tw-xy/LintLizard/README.md

# LintLizard —— 履带扫地机器人 · 固件仓库



> **LintLizard** 是我给这台履带扫地机器人起的名字：**Lint**（毛絮、灰尘）+ **Lizard**（蜥蜴）——
> 一只贴着地面爬来爬去、专门吃掉毛絮的蜥蜴。
>
> 本仓库是它的**固件与文档**，会跟着功能一起长大。目前已经完成
> **遥控底盘、电调驱动、OLED 状态显示、扫地执行机构和激光雷达前向避障**；
> 后面继续加入自动回充、树莓派建图、编码器闭环等功能。

```
手机 Blinker 摇杆 → ESP8266-01S → CH32V307 → 标准差速转向 → 双有刷电调 → 履带底盘
```

板子：**CH32V307V-EVT**（丝印 `CH32F&V30xV-R1-1v1`，主控 CH32V307VCT6，板载 WCH-Link）

> 仓库名对应的是**整机**（LintLizard），不是当前阶段，所以以后加功能不用改名；
> 要区分版本时用 `LintLizard-v1` 这种形式。

## 当前进度

| 阶段 | 状态 |
|---|---|
| 一、娱乐与遥控（摇杆 → 串口协议 → 差速解算 → COM4 打印） | ✅ 已完成并实测 |
| 二、电调输出（TIM3 双路 50Hz / 1000–2000µs PWM） | ✅ 已实测；轮子转向已确认 |
| 三、OLED 状态显示（SSD1306 软 I2C） | ✅ 已烧录并跑通状态机；屏幕观感待确认 |
| 四、扫地执行机构（边刷 EN + 涡轮风机缓启动） | ✅ 已实测 |
| 五、激光雷达（YDLIDAR X2 兼容） | ✅ CH32 数据链路 + PC 端 EaiLidarTest 点云 + 前向避障均已验证 |
| 六、树莓派上位机（Web 控制台） | ✅ WiFi + SSH + 串口 + MJPEG + 网页摇杆 + **真实雷达点云**；新固件已烧录，约 409 点/秒，网页实测显示，双向串口验证通过 |
| 后续 | 落地跑直线/原地转 / 避障阈值精调 / 树莓派建图 / 编码器闭环（架构已预留接口） |

## Web 控制台实测

虚拟摇杆、W/A/S/D 键盘、CSI 摄像头 MJPEG 与实时雷达点云同屏显示。
W 前进、S 后退、A 左转、D 右转，支持组合键；松开、空格、Esc 或切走窗口停车。
键盘速度默认 50%，可调 20%～100%；网页指令使用纯手动模式，松手保持停止。

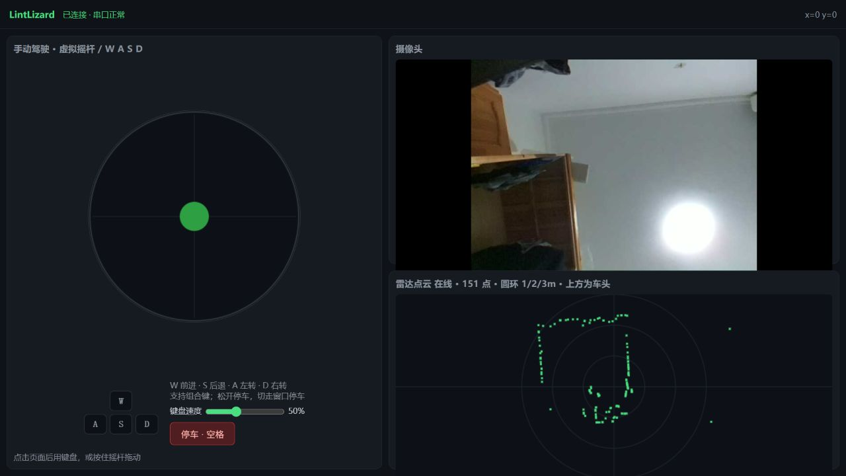
[picture p1: docs/images/20260922_05_web_wasd.png]
WASD 键盘控制界面


2026-09-22 用户提供的点云联调截图：

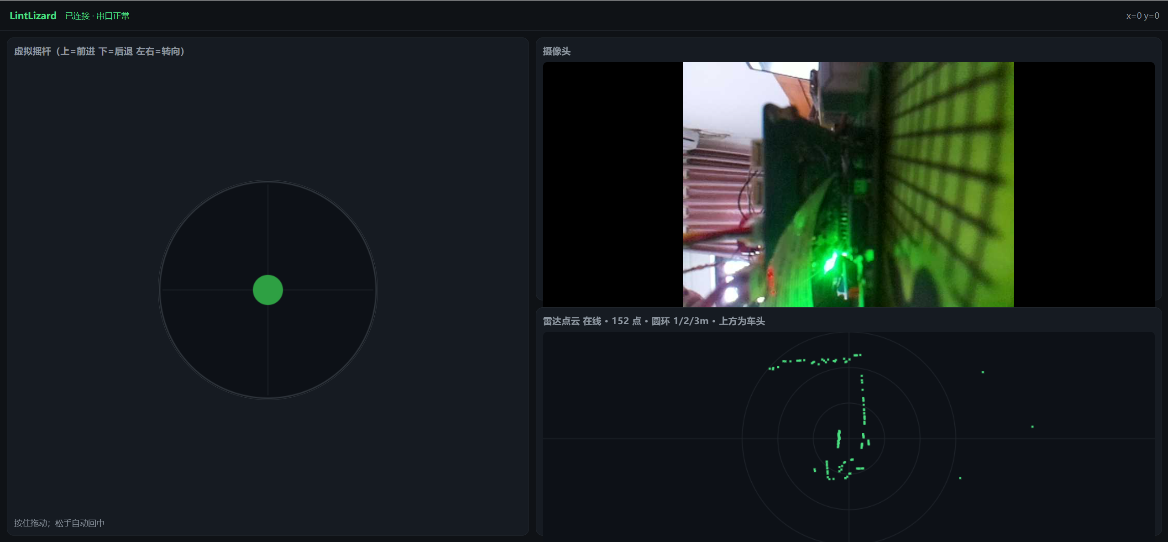
[picture p2: docs/images/20260922_04_web_console_user.png]
LintLizard Web 控制台：摇杆、摄像头与实时雷达点云


## 目录结构

```
User/  Bsp/  App/        CH32V307 固件源码
  User/main.c            主循环时间片调度
  Bsp/bsp_time.c         TIM2 1ms 时基 + 软定时器
  Bsp/bsp_uart.c         USART1 调试口 / USART3 遥控口（中断 + 环形缓冲）
  Bsp/bsp_motor.c        TIM3_CH1/CH2 → 两路电调 PWM
  App/app_remote.c       行协议解析 + 链路超时
  App/app_chassis.c      差速解算（换底盘只动这里）
  App/app_config.h       全部可调参数
sdk/                     随仓库自带的一份 WCH 官方库（Core/Peripheral/Ld/Startup）
esp8266/ESP8266_Blinker_Joy/   ESP8266 端 Arduino 工程
pi/                       树莓派上位机 Web 控制台（摇杆 + MJPEG 摄像头 + 点云）
  pi/server.py            纯标准库 HTTP 服务：/cmd → /dev/serial0、/video MJPEG
  pi/lintlizard-web.service  systemd 开机自启
  pi/README.md             部署与排查
backup/                       出厂固件备份（想恢复出厂时用，见 backup/README.md）
docs/                    接线表 / 避坑清单 / 编译环境 / 开发日志 / AI 提示词
build.ps1 flash.ps1 log.ps1    编译 / 烧录 / 串口记录
```

## 五分钟上手

```powershell
cd <本仓库目录>

# 1. 编译（输出 build\CAR_REMOTE.elf / .hex / .bin）
powershell -ExecutionPolicy Bypass -File .\build.ps1

# 2. 烧录（WCH-LinkE，会覆盖板子上现有程序）
powershell -ExecutionPolicy Bypass -File .\flash.ps1

# 3. 看板子在说什么（COM4 @115200，存到 logs\serial_*.log）
powershell -ExecutionPolicy Bypass -File .\log.ps1 -Seconds 60
```

正常应该看到：

```
[cmd ] x=  +0 y=  +0 | L=   +0 R=   +0 | 1500/1500 us | ok
[stat] LINK-OK  frames=2971 (48/s) err=0 rx=41594 rxovf=0 txdrop=0
```

ESP8266 端：用 Arduino IDE 打开 `esp8266/ESP8266_Blinker_Joy/`，
把 `secrets.h.example` 复制成 `secrets.h` 填上 WiFi / Blinker Secret Key（该文件已被 git 忽略），
开发板选 `Generic ESP8266 Module` / `1MB (FS:none OTA:~502KB)` / 26MHz / 80MHz。

## 硬件接线

见 [docs/接线表.md](docs/接线表.md)：板子 ↔ ESP8266、板子 ↔ 电调、板子 ↔ USB-TTL，
以及**板子上已经被占用的引脚清单**（接新东西前先看这张表）。

## 文档

| 文档 | 用途 |
|---|---|
| [docs/接线表.md](docs/接线表.md) | 全部接线 + 电源拓扑 + 已占用引脚 |
| [docs/避坑Checklist.md](docs/避坑Checklist.md) | 出问题先翻这个（串口乱码/连不上云/烧不进…） |
| [docs/编译环境.md](docs/编译环境.md) | 需要装什么、什么版本、怎么验证、怎么排错 |
| [docs/开发日志.md](docs/开发日志.md) | 完整开发记录：协议、算法、实测数据、踩坑过程 |
| [docs/下一步AI提示词.md](docs/下一步AI提示词.md) | 开新对话继续开发时，直接粘给 AI 的上下文 |

## 设计要点

* **非阻塞**：`BSP_Millis()` + `BSP_Every()` 时间片；串口收发全中断 + 环形缓冲；**没有任何 `Delay_Ms()` 死等**
* **三层失效保护**：ESP 端 1s 无摇杆数据回中 → 链路 300ms 无有效帧判离线 → 底盘 300ms 无新指令输出归零
* **协议可扩展**：`{"x":-100,"y":100}\n` 一行一帧，只认 `{` 开头的行，多余的键随便加
* **归一化差速**：`l=y+x, r=y-x` 后等比缩放，保证"斜着推"时转向比例不失真

## 后续扩展接口

| 功能 | 加在哪 | 接口 |
|---|---|---|
| 编码器测速 / PID | `Bsp/bsp_encoder.c` + `App/app_chassis.c` | 复用 `Chassis_Output_t` |
| 扫地（主扫/吸尘/边刷） | `App/app_cleaner.c` | 新增 PWM 通道 |
| 自动回充（红外 + 触点） | `App/app_charge.c` | 调 `Chassis_SetInput()` |
| ToF/超声波避障 | `App/app_avoid.c` | 在 `main.c` 里与遥控做仲裁 |
| OLED / WS2812 | `App/app_ui.c` | 只读状态，不阻塞 |

## 说明

* `sdk/` 为 WCH 官方 CH32V30x 外设库（随 EVT 包分发），版权归南京沁恒微电子所有，此处仅为便于编译而随仓库附带。
* 本仓库不包含任何 WiFi 密码或设备密钥。
