tw-xy/LintLizard/docs/任务交接摘要.md

# LintLizard 任务交接摘要

> 生成时间：2026-09-22
> 仓库：https://github.com/tw-xy/LintLizard （public，分支 `main`）
> 本地工程：`D:\WCH_CH32V307_EVT\projects\CAR_REMOTE`
> 用途：开新对话时把这份内容整段粘进去，即可无损接手。

---

## 1. 当前核心目标（一句话）

**把 LintLizard 履带扫地机器人的上位机从「ESP8266 + 点灯科技」迁到「树莓派 3B+ 网页控制」。**
网页的虚拟摇杆、摄像头 MJPEG 和**真实雷达点云均已打通**；2026-09-22 新固件已烧录并完成静态联调。

---

## 2. 环境（已装好，不要再问用户路径）

| 项 | 值 |
|---|---|
| 板子 | CH32V307V-EVT（丝印 `CH32F&V30xV-R1-1v1`，主控 CH32V307VCT6，板载 WCH-Link） |
| IDE | `D:\MounRiverStudio\MounRiver_Studio2` |
| 工具链 | `...\WCH\Toolchain\RISC-V Embedded GCC\bin` |
| 烧录 | `...\WCH\OpenOCD\OpenOCD\bin\openocd.exe` + 同目录 `wch-riscv.cfg`（WCH-LinkE，SDI 两线；脚本里路径**必须用正斜杠**） |
| 板子串口 | **COM4 @115200**（USART1 → 板载 WCH-Link 透传，可直接读写） |
| ESP 端 | Arduino IDE 2.3.10 + esp8266 3.1.2 + Blinker 库 |
| 代理 | Clash Verge Rev，**TUN 模式必须保持关闭**（开了会劫持局域网 IPv4，连不上树莓派） |

树莓派：Raspberry Pi 3B+，Raspberry Pi OS Lite 64-bit (Trixie)，hostname `lintlizard`，用户 `pi`

- SSH 公钥免密已配好：私钥 `C:\Users\hp\.ssh\lintlizard_ed25519`
- WiFi `miaomiaomao2.4G` → `192.168.1.5`（autoconnect，**WiFi 省电已关闭**）
- 历史备用地址：Ethernet `192.168.1.213`
- 最近实测 Web 服务、键盘界面、雷达均正常；用户随后已给小车断电，计划晚上继续。
  WASD 网页和配套固件已在断电前部署/烧录校验成功；晚上上电后刷新页面，先验证实际按键行驶，通常无需重复烧录。

---

## 3. 已完成进度

| 阶段 | 状态 |
|---|---|
| 一、遥控（摇杆 → ESP8266 → USART3 → 差速解算 → COM4） | ✅ 实测通过 |
| 二、电调驱动（TIM3_CH1/CH2，50Hz / 1000–2000µs） | ✅ 实测，轮子转向已确认 |
| 三、OLED（SSD1306 软 I2C，三态界面 + 方向箭头） | ✅ 已跑通（`oled=1`） |
| 四、扫地执行机构（边刷 EN + 涡轮风机 18kHz 缓启动） | ✅ 实测通过 |
| 五、激光雷达（YDLIDAR X2 兼容） | ✅ CH32 侧 9400 B/s；PC 端 EaiLidarTest 点云；前向避障四态全通过 |
| 特别版：自动巡航 `App/app_roam.c` | ✅ 已烧录；旧 ESP 指令推杆武装/下拉急停；网页 `manual=1` 纯手动，松手保持停止 |
| 六、树莓派上位机 | ✅ SSH / WiFi / 串口 / 摇杆 / 摄像头 / **真实网页点云**；固件已烧录，静态双向串口联调通过 |

Web 控制台现状：`http://192.168.1.5:8080/`

- 左边虚拟摇杆 → 实测通到 CH32（`LINK-OK`、约 8 帧/秒、解算正确）
- 已追加 WASD 键盘：W前进/S后退/A左转/D右转，组合键、速度20%～100%（默认50%），空格/Esc停车；失焦/隐藏/取消触控回中。网页现在统一纯手动，100ms持续发送；配套固件已烧录，静态10帧/秒、err=0、rxovf=0，非零方向仅隔离测试。
- 右上摄像头 MJPEG → OV5647 实测 6 秒 73 帧（约 12fps）
- 右下**真实雷达点云已显示**：约409点/秒，5.33s 测试期间保留140–177个新鲜点，Pi解析错误增量0。
- 新 Pi 接收服务已部署：`R,angle_cdeg,dist_mm`，每度最新点，0.5s 过期；状态可看 `/status.radar`。
- 固件编译、Pi 7 项测试与 C 解析器主机测试通过；OpenOCD 烧录 Verified OK。
- 双向串口实测50条回中指令，LINK-OK、err=0、rxovf=0，电调1500/1500µs；未测试非零摇杆/落地。
- 启动初期转发丢弃6点，之后累计不增；截图 `docs/images/20260922_03_web_radar_live.png`。

---

## 4. 当前引脚分配（实际接线）

| 功能 | 引脚 / 板子位置 |
|---|---|
| 左电调信号 | PA6 = J4-29（TIM3_CH1，50Hz，1500µs=停） |
| 右电调信号 | PA7 = J4-31（TIM3_CH2） |
| 吸尘电调 | PB0 = J4-17（TIM3_CH3） |
| 涡轮风机 PWM | PB8 = J4-25（TIM4_CH3，18kHz 占空比） |
| 边刷 1 / 2 EN | PE8 = J3-43 / PE10 = J3-45（高电平开） |
| OLED | SCL→PB6=J4-22、SDA→PB7=J4-20（I2C1，地址 0x3C） |
| 雷达 | Tx → PA3 = J3-34（USART2_RX，115200）；M_CTR 接 3.3V（**不是 RXD**） |
| 树莓派 AAT-1 | AAT-1 RX→J4-1(PB10/USART3_TX)、AAT-1 TX→J4-3(PB11/USART3_RX)、GND→J4-7、**5V 不接** |
| 调试串口 | PA9/PA10（USART1）→ 板载 WCH-Link → COM4 |
| 电调红线 | BEC 悬空包好，**绝不能接进板子** |

---

## 5. 树莓派侧已做的系统改动

- **UART**：`/boot/firmware/config.txt` 末尾（`[all]` 段）加 `enable_uart=1` + `dtoverlay=disable-bt`；
  `/boot/firmware/cmdline.txt` 去掉 `console=serial0,115200`；重启后 `/dev/serial0 -> ttyAMA0`（PL011，115200 8N1）
- **WiFi 省电**：`nmcli connection modify miaomiaomao2.4G wifi.powersave 2`
- **Web 服务**：`pi/server.py`（纯标准库，无 pip 依赖）+ `pi/lintlizard-web.service`（systemd 开机自启）
  - 部署：`scp pi/server.py pi@<IP>:/home/pi/lintlizard-server.py`
  - 排查：`systemctl status lintlizard-web` / `journalctl -u lintlizard-web -n 50` / `curl -s localhost:8080/status`
  - 接口：`/` 页面、`/cmd?x=&y=` 指令、`/video` MJPEG、`/scan` 点云、`/status` 状态

---

## 6. 已排除的错误方案 / 必须记住的坑

1. **ESP8266 的 EN 必须接 3.3V**，悬空不启动（蓝灯不亮）
2. **ESP 供电不能从 USB-TTL 或板子 3.3V 取**，要独立 3.3V（≥500mA）
3. **YDLIDAR X2 第 4 脚是 `M_CTR`（电机调速），不是卖家标的 `RXD`**
4. **Raspberry Pi Imager 2.0.11.1 会崩**（`libstdc++-6.dll`），用 **1.9.6**
5. **Clash TUN 会劫持局域网 IPv4**：症状是 IPv4 超时但 IPv6 通、ARP 通 → 关掉 TUN
6. **中文 SSID 在 Linux 控制台打不出来** → 改英文；路由器**实际 2.4G 名是 `miaomiaomao2.4G`**（是 `mao` 不是 `miao`），5G 才是 `miaomiaomiao5G`
7. **树莓派 UART 默认没开**（`/dev/ttyAMA0` 都不存在），按第 5 节那三步改
8. **WiFi 省电会导致树莓派随机掉线**，已关
9. `.ps1` 在 PowerShell 5.1 会中文乱码 → 脚本一律纯 ASCII
10. **Clash fake-IP 会让 `lintlizard.local` 解析到 `198.18.0.x`** → 直接用真实 IP
11. 树莓派**屏蔽 ICMP**，`ping` 不通不代表掉线，要用 SSH/端口判活
12. `git` 里已经把 `*.py/*.service/*.sh` 设为 LF（`.gitattributes`）

---

## 7. 尚未解决 / 当前阻塞点

1. **点云阻塞已解决**：TX→PA3/J3-34、GND→J4-7、VCC→独立5V、M_CTR→3.3V。
   `app_radar.c` 抽样转发、`ESP_TryWriteFrame` 整行入队，Pi `RadarBuffer` 接收并过期清理。
   当前是局部实时点云显示，尚未做建图或定位。
2. 网页**没有登录验证**（本地还行，暴露公网很危险）
3. **无法远程访问**（`192.168.1.5` 是局域网私有地址）。要远程建议装 **Tailscale**（免公网 IP、免端口映射、加密）
4. 落地跑**直线 / 原地转**还没做
5. **编码器 + IMU 暂缓采购**（用户已决定）

---

## 8. 下一步具体行动（接手后第一步）

1. 让用户给车上电，确认连通：
   `ssh -i C:\Users\hp\.ssh\lintlizard_ed25519 pi@192.168.1.5 "hostname; systemctl is-active lintlizard-web"`
2. 点云已完成，不要重复烧录。若检查状态，可核对 COM4 `[rad]` / `[scan] sent/drop`
   与 Pi `/scan`、`/status.radar`。静态检查保持摇杆回中；当前网页为纯手动，旧 ESP 指令仍可能武装巡航。
3. 下一任务按用户选择：网页登录验证 → Tailscale 远程 → 落地跑直线/原地转。

---

## 9. 协作约定（务必遵守）

- 分工：**用户负责下载/安装/物理接线/拍照；AI 负责写代码、编译、烧录、读串口、更新文档**
- **凡是会覆盖板子程序的（烧录），先说一声再动手**
- 涉及接线时，给「**板子端引脚 + 模块端引脚**」的接线表
- 每个里程碑：**提交 git + 更新文档**
- 用户**不熟悉命令行**：尽量少让他敲命令，命令给短、给明确
- 交流用中文，**先说结论**，再给依据
- 用户累了会暂停，不要催

---

## 10. 远期规划与架构要求

- 远期：扫地主刷/滚刷、自动回充（红外寻桩 + 触点）、ToF/超声波、GPS/罗盘、OLED 弹幕、WS2812、ESP32-CAM 图传
- 架构硬要求：**非阻塞**（时间片轮询），**严禁 `Delay_Ms()` 死等**；
  分层 `User/(主循环) Bsp/(时基/串口/电机/风机/OLED) App/(协议/差速/扫地/雷达/避障/巡航/UI)`，参数集中在 `App/app_config.h`
- 失效保护三层：ESP/Pi 端超时回中 → 链路 300ms 判离线 → 底盘输出归零；雷达失效锁前进

---

## 11. 空闲 IO 预算（已核算）

- **CH32V307VCT6**：GPIO 共 72 个，已用 27 个，**还剩 45 个**可用
  （PA0/1/2/4/5/8/15、PB1/2/3/4/5/9/12–15、PC0–PC5/10–13、PD2–PD7、PE0–PE6/11–15；
  注意 PB2 是 BOOT1，上电瞬间别拉高）
- **树莓派 3B+**：40-pin 上 GPIO0–27 共 28 个，去掉 GPIO14/15（AAT-1），**还剩 26 个**
- 参照图：`C:\Users\hp\Documents\ChatGPT\硬件相关\CH32V307V-EVT_sch_p11-11.png`（原理图第 11 页，J3/J4 各 2×27）

---

## 12. 文档地图

| 文档 | 用途 |
|---|---|
| `README.md` | 项目总览 + 当前进度表 |
| `docs/接线表.md` | 全部接线 + 电源拓扑 + 已占用引脚 |
| `docs/避坑Checklist.md` | A–H 八节，出问题先翻它 |
| `docs/编译环境.md` | 环境安装说明 |
| `docs/开发日志.md` | 完整开发记录 + 图集 |
| `docs/下一步AI提示词.md` | 新对话上下文（本文件是它的详细版） |
| `docs/images/` | 已归档的里程碑截图与实拍 |
