tw-xy/LintLizard/docs/开发日志.md

# LintLizard 开发日志

> 板子：CH32V307V-EVT（丝印 `CH32F&V30xV-R1-1v1`，主控 CH32V307VCT6，板载 WCH-Link）
> 工程：本仓库根目录
> 仓库：https://github.com/tw-xy/LintLizard
> 记录时间：2026-09-14 ~ 09-22

## 当前状态（每次更新先改这里）

| 项 | 状态 |
|---|---|
| 阶段一：遥控（摇杆 → ESP → 协议 → 差速 → 串口打印） | ✅ 实测通过（方向全对 / 48 帧每秒 / err=0） |
| 阶段二：驱动电调（TIM3_CH1/CH2，50Hz / 1000–2000µs） | ✅ 寄存器级 + 推杆实测；**轮子转向已确认** |
| 阶段三：OLED 界面（无网络转圈 / 已连接 / 方向箭头） | ✅ 代码完成并烧录；屏幕已识别（`oled=1`）、状态机已跑通（`ui=direction dir=stop`）——**屏幕实际观感待确认** |
| 阶段四：扫地执行机构（边刷 EN + 涡轮风机 18kHz 缓启动） | ✅ 实测通过（用户确认；含修正上电误启动 bug） |
| 阶段五：激光雷达（YDLIDAR X2 兼容） | ✅ **数据链路 + 电脑点云 + 前向避障均已实测**：CH32 侧约 9400 B/s / 168 包每秒；PC 端 EaiLidarTest 7.8Hz；避障 `CLEAR/SLOW/STOP/FAULT` 四态全部通过 |
| **下一步** | 网页真实点云已验证；后续由用户选择网页登录验证、远程访问或落地跑直线/原地转（含避障） |
| 硬件采购待办 | **编码器 + IMU 暂缓采购**（选型要求见 `docs/下一步AI提示词.md`）；扫地主刷/滚刷电机优先找扫地机拆机件 |
| 树莓派阶段 | Raspberry Pi OS Lite 64-bit (Trixie)；SSH 公钥免密已通；WiFi 已连 `miaomiaomao2.4G`（IP `192.168.1.5`，autoconnect）；**Pi ↔ CH32 串口链路已打通**（AAT-1 ↔ USART3） |
| 代码规模 | 自研约 2100 行（`User/ Bsp/ App/`，另含自动生成字模 259 行）；随仓库自带 `sdk/`（沁恒官方） |
| 构建 | `build.ps1`（Windows）/ `build.sh`（Linux、CI）；GitHub Actions 每次 push 自动编译两端 |
| 出厂固件 | `backup/backup_factory_20260911.bin`（294912 B；SHA256 与恢复命令见 `backup/README.md`） |

---

## 关于名字：为什么叫 LintLizard

**LintLizard** = **Lint**（毛絮、绒毛、灰尘）+ **Lizard**（蜥蜴）——
一只贴着地面爬行、专吃毛絮的蜥蜴，就是这台履带扫地机器人的形象。

* 名字定于 2026-09-15，仓库 `tw-xy/LintLizard`，**不改名**。
* 仓库名对应的是**整机**，不是当前阶段。现在仓库里只有第一阶段（遥控底盘）的功能，
  后面扫地、自动回充、避障导航、OLED/图传都往这个仓库里加，所以名字不会过时。
* 要区分版本时用 `LintLizard-v1`、`LintLizard-v2` 这种说法，仓库名保持不动。

---

## 0. 速查表

| 项目 | 值 |
|---|---|
| 主控 | CH32V307VCT6，LQFP100，HSE 8MHz → PLL 96MHz |
| SDK | `D:\WCH_CH32V307_EVT\extracted\EVT\EXAM\SRC`（官方外设库） |
| 工具链 | `...\MounRiver_Studio2\...\Toolchain\RISC-V Embedded GCC\bin`（riscv-none-embed-gcc 8.2.0） |
| 架构选项 | `-march=rv32i -mabi=ilp32`（与官方例程 obj 配置一致） |
| 烧录 | `...\WCH\OpenOCD\OpenOCD\bin\openocd.exe -f wch-riscv.cfg`（WCH-LinkE，SDI 两线） |
| 调试串口 | USART1 (PA9/PA10) → 板载 WCH-Link → **COM4 @115200** |
| 雷达调试串口 | WCH-LinkE SERIAL **COM6 @115200**（EaiLidarTest）；雷达 Tx → LinkE RX，M_CTR → 3.3V |
| 遥控串口 | USART3 (PB10/PB11) → ESP8266-01S @115200 |
| 电调输出 | TIM3_CH1=PA6、TIM3_CH2=PA7，50Hz / 1000~2000µs |
| 系统时基 | TIM2 1ms 中断（非阻塞时间片） |
| 仓库 | https://github.com/tw-xy/LintLizard（公开，`main` 分支，CI 自动编译两端） |
| 出厂固件备份 | `backup/backup_factory_20260911.bin`（294912 B） |

**三条命令**（都在工程目录下跑）：

```powershell
powershell -ExecutionPolicy Bypass -File .\build.ps1              # 编译 -> build\CAR_REMOTE.elf/.hex/.bin
powershell -ExecutionPolicy Bypass -File .\flash.ps1              # 烧录（会覆盖板子现有程序）
powershell -ExecutionPolicy Bypass -File .\log.ps1 -Seconds 60    # 录 COM4 -> logs\serial_*.log
```

Linux / CI 里用同样参数的 `bash build.sh`（GitHub Actions 就是这么编译两端的）。

---

## 1. 阶段一：娱乐与遥控（已完成 ✅）

### 1.1 数据链路

```
手机 Blinker 虚拟摇杆
     │ WiFi / 云
ESP8266-01S ──USART3(PB10/PB11,115200)──► CH32V307
                                            │ ① 行协议解析
                                            │ ② 差速解算
                                            ▼
                          USART1(PA9/PA10)=COM4 打印左右目标速度
```

### 1.2 引脚分配（依据：官方原理图 `PUB\CH32V30xSCH.pdf` 第 11 页 = VCT6-R1 板）

| 信号 | 引脚 | 板上位置 | 说明 |
|---|---|---|---|
| USART3_TX | PB10 | J4 第 1 脚（网络名 D15） | → ESP 的 RX |
| USART3_RX | PB11 | J4 第 3 脚（网络名 D14） | ← ESP 的 TX |
| GND | — | J4 第 7 脚 | 共地 |

**为什么选 USART3**：板上已被占用的资源 —— USART1(PA9/PA10)=WCH-Link 调试串口、PA13/PA14=SWD、
PA11/PA12=USB-HS、PB6/PB7=USB-FS+OLED、**PC6/PC7/PC8/PC9=内置 10M 以太网 PHY 差分线（接 HR911105A 网口）**、
PE9/PE7=用户 LED 跳线。USART3 的默认脚 PB10/PB11 完全空闲，且在 J4 上相邻、旁边就是 GND。

### 1.3 通信协议

115200 8N1，一行一帧，`\n` 结尾：

```json
{"x":-100,"y":100}
```

| 字段 | 范围 | 含义 |
|---|---|---|
| x | -100 ~ +100 | 左负右正（转向） |
| y | -100 ~ +100 | 后退负、前进正（油门） |

解析规则：只接受以 `{` 开头的行，只找 `x`/`y` 两个键，其它字段随便加。
ESP8266 上电时 74880 波特的启动乱码、Blinker 日志都会被安全丢弃（不占 err 计数以外的任何资源）。

### 1.4 差速解算

```
死区(±4%) → 指数曲线(可配) →  l = y + x ,  r = y - x  → 归一化 → 千分比输出(±1000‰)
```

归一化的作用：前进 100 + 右转 100 时 l=200/r=0，两边等比缩放到 l=1000‰/r=0‰，
**转向比例不失真**（不做归一化就会削掉一边、转角变化）。

### 1.5 非阻塞架构

* `BSP_Millis()`：TIM2 1ms 中断提供唯一时基；`BSP_Every(&last, period)` 做软定时器
* 主循环按 10ms（控制）/ 20ms（电调）/ 100ms（打印）/ 1s（统计）分片，**没有任何 `Delay_Ms()`**
* USART1/USART3 全部中断 + 环形缓冲；连 newlib 的 `_write()` 都重定向到环形缓冲，误用 `printf` 也不会死等
* 三层失效保护：ESP 端 1s 无摇杆数据回中 → 链路 300ms 无有效帧判离线 → 底盘 300ms 无新指令输出归零

### 1.6 实测验证数据

摇杆方向（一次完整推杆的记录）：

| 推杆方向 | x | y | L | R | 判定 |
|---|---|---|---|---|---|
| 正上（前） | +12 | **+100** | +999 | +784 | ✅ 前进为正 |
| 正下（后） | +3 | **-100** | -1000 | -1000 | ✅ 后退为负 |
| 正左 | **-99** | +20 | -677 | +999 | ✅ 左为负 |
| 正右 | **+100** | +7 | +999 | -868 | ✅ 右为正 |
| 右到底 | +100 | 0 | **+1000** | **-1000** | ✅ 完美原地右转 |

链路质量（连续运行 20s）：

```
[stat] LINK-OK  frames=2971 (48/s)  err=0  rx=41594  rxovf=0  txdrop=0
```

`frames` 单调递增从不归零 → 无重启；`err=0` → 一行都没解析错；两个缓冲零溢出。

### 1.7 遥控操作语义（怎么开、怎么停）

| 操作 | 行为 |
|---|---|
| 推摇杆 | 车按该方向**持续跑**（ESP 保持最后一次摇杆值，不会因为"按住不动"而掉速） |
| 把摇杆拖回中间 | **停车**（Blinker 摇杆只在手指移动时上报，拖动就会发 0,0） |
| 手机 / 云端断开 | ESP 检测到 `Blinker.connected()==false` → 自动归零 |
| 串口断了 / 主控异常 | CH32 侧 300ms 链路超时兜底 → 输出 0 并打印 `FAILSAFE` |

> ⚠️ 注意：**手指离开但没把摇杆拖回中间，车会保持最后速度继续跑**（"定速"语义）。
> 这是 Blinker 摇杆组件"事件式上报"的固有特性，不是 bug。
> 想要"按住才走、松手立停"的手感，要么换成局域网网页摇杆（能拿到触摸抬起事件），要么加"急停按钮"。

**实测验证（2026-09-15）**：改完后按住推杆 8 秒，`y` 稳定在 **+100** 从不归零，
脉宽保持 **1999/1943µs**，`frames` 单调递增（932→1268，48 帧/秒）、`LINK-OK` 全程稳定 → **"跑几秒就停"已解决**。

停车也一并验证：推住 3.5 秒（脉宽 1999/1909µs 不掉速）→ **把摇杆拖回中间** → `y` 立刻回 0、脉宽回 **1500/1500µs** → 再推又能启动。
开关车三段动作（开 → 停 → 再开）全部实测通过。

---

## 2. 阶段二：电调输出（信号层已验证 ✅，轮子转向待确认）

### 2.1 引脚

| 信号 | 引脚 | 板上位置 | 目标 |
|---|---|---|---|
| TIM3_CH1 | **PA6** | **J4 第 29 脚（丝印 D4）** | 左电调 信号线 |
| TIM3_CH2 | **PA7** | **J4 第 31 脚（丝印 D3）** | 右电调 信号线 |
| GND | — | J4 第 7 脚 | 两个电调的黑线 |

接线纪律（重要）：

1. **电调红线（BEC 5V/6V 输出）不接板子**，悬空包好
2. 电调动力电走**电池**（2S/3S 锂电），不要从板子 5V/3.3V 取
3. 电调 GND 必须与板子 GND 相连（信号要有参考电平）
4. 上电顺序：**先给板子上电**（程序跑起来输出中位）→ 再给电调上电池（电调读中位自检）

### 2.2 信号格式

标准 RC 有刷电调：**50Hz（20ms 周期）**，脉宽 `1000µs = 满倒车`、`1500µs = 中位(停)`、`2000µs = 满前进`。
上电后 3 秒（`MOTOR_ARM_DELAY_MS`）强制保持中位，给电调自检/解锁用。

### 2.3 寄存器级验证（openocd 直接读 TIM3）

```
CR1  = 0x81      CEN + ARPE
CCER = 0x11      CC1E | CC2E（两路输出使能）
PSC  = 0x5F(95)  96MHz / 96 = 1MHz → 1 计数 = 1µs
ARR  = 0x4E1F    19999 → 20ms = 50Hz
CCR1 = 0x5DC     1500µs（左，中位）
CCR2 = 0x5DC     1500µs（右，中位）
```

不用示波器也能自测：万用表直流电压档量 PA6/PA7 对 GND —— 中位 ≈0.25V、满前进 ≈0.33V、满倒车 ≈0.17V。

### 2.4 推杆实测（日志 `logs\serial_20260915_001224.log`）

| 时刻 | 动作 | x | y | L | R | 脉宽 | 判定 |
|---|---|---|---|---|---|---|---|
| 0.1s | 松手 | 0 | 0 | 0 | 0 | **1500/1500 µs** | ✅ 中位 |
| 4.1~6.2s | 推前 | ≈0 | +100 | +1000 | +1000 | **2000/2000 µs** | ✅ 满前进 |
| 11.7~12.7s | 推后 | -7 | -100 | -999 | -868 | **1001/1048 µs** | ✅ 满倒车 |
| 20.0~22.6s | 再推前 | ≈0 | +100 | +1000 | +1000 | **2000/2000 µs** | ✅ 复现 |
| 24.6~25.6s | 再推后 | -5 | -100 | -999 | -904 | **1001/1048 µs** | ✅ 复现 |

### 2.5 待办：轮子实际转向

把车架起来（履带悬空），逐个确认：

| 推杆 | 期望 |
|---|---|
| 前 | 两条履带都朝车头方向转 |
| 后 | 两条都朝车尾方向转 |
| 右 | 左履带往前、右履带往后（原地右转） |
| 左 | 左履带往后、右履带往前（原地左转） |

反了就把 `app_config.h` 里 `MOTOR_LEFT_INVERT` / `MOTOR_RIGHT_INVERT` 改成 1 重烧（比调线干净）。

---

## 3. 踩过的坑（下次直接看这节）

| # | 现象 | 根因 | 解决 |
|---|---|---|---|
| 1 | `.ps1` 脚本报"字符串未终止/意外标记" | Windows PowerShell 5.1 把**无 BOM 的 UTF-8 .ps1 当 GBK 解**，中文串把引号吃掉了 | 脚本里的字符串只用 ASCII（中文只留在注释外的地方/改成英文注释） |
| 2 | openocd 报 `couldn't open D:WCH_CH32V307_EVTprojects...` | openocd 的 `-c` 参数由 **Tcl 解析**，Windows 路径的反斜杠被当转义（`\b` 变退格） | 路径写成**正斜杠** `D:/.../x.elf` |
| 3 | 脚本一调用 openocd 就抛 `NativeCommandError` | openocd 把 banner 写到 **stderr**，而脚本设了 `$ErrorActionPreference='Stop'` | 调用前后临时设 `'Continue'`，用 `$LASTEXITCODE` 判断成败 |
| 4 | Arduino 开发板管理器装 ESP8266 包总是超时 | **Arduino CLI 不读系统代理/环境变量**，直连 GitHub 被打断 | 写 `%LOCALAPPDATA%\Arduino15\arduino-cli.yaml`：`network.proxy: http://127.0.0.1:7897` |
| 5 | 单独供电时点灯 APP 永远"不在线"，插上烧录器就在线 | ESP8266 连 WiFi 瞬时吃 **300~500mA**，弱电源直接塌陷 → 反复重启 | 独立 3.3V（≥500mA，5V+AMS1117-3.3），模块旁并 470µF+100nF；**USB-TTL 的 3.3V 带不动** |
| 6 | 用了带 `-5G` 的 5GHz SSID，怎么都连不上 | ESP8266 **只支持 2.4GHz** | 换成 2.4G 的 SSID |
| 7 | 烧录后 COM4 全是乱码，所有波特率都不对 | WCH-Link 的串口桥没跟目标对上（波特率本身没错：57600~921600 全扫过，只有 115200 正常） | **复位一次**（板上 S3 或 openocd reset）即恢复；判断依据：CPU halt 住后数据立刻归零 → 数据确实来自芯片 |
| 8 | COM4 突然消失，设备管理器里状态 `Unknown` | 板子断电/USB 掉枚举 | 插回 USB；下电后 COM4 消失是正常现象 |
| 9 | 原理图 PDF 文字读不出来 | Altium 导出的 PDF 文字被打散成单字符，按坐标拼不可靠 | 用 pypdfium2 **高倍渲染成图片**再读；或直接看关键区域的裁剪图 |
| 10 | Blinker 库编译报警告一大堆 | 库自身 `-Wwrite-strings` / `WiFiServer::available` 已废弃 | 与我们无关，忽略；我们自己的文件是 0 warning |
| 11 | ESP 上电串口先吐一段乱码 | ESP8266 ROM 用 74880 波特率打印启动信息 | 协议解析器只认 `{` 开头的行，自动丢弃 |
| 12 | 一次性命令里写 Windows 路径给原生程序，反斜杠会被吃掉 | PowerShell 向原生程序传参时的转义/引号处理 | 尽量用 `-File 脚本.ps1` 方式调用，路径在脚本内部处理 |
| 13 | 单独供电时 ESP 完全不启动（蓝灯不亮、串口无输出），插烧录器就正常 | **EN(CH_PD) 悬空** —— 我们这块模块没有可靠上拉（官方 ESP-01S 图上 R2 10K 是有的，但不是所有模块都焊/都有效）；另外蓝灯是接在 TXD/GPIO2 上的**数据灯**，不是电源灯 | **EN 直接接 3.3V**；判断模块死活看串口，不看灯 |
| 14 | 推杆后车**跑几秒自己停** | ESP 里"1 秒没收到摇杆数据就回中"的失效保护，把"按住不动"误判成"松手"（**Blinker 摇杆只在手指移动时上报**） | 改成保持最后值 + `!Blinker.connected()` 才归零；停车 = 把摇杆拖回中间 |

---

## 4. 参数速查（`App/app_config.h`）

| 宏 | 当前值 | 含义 |
|---|---|---|
| `DBG_UART_BAUD` / `ESP_UART_BAUD` | 115200 | 调试口 / 遥控口波特率 |
| `REMOTE_LINK_TIMEOUT_MS` | 300 | 多久没收到有效帧判定链路断开 |
| `CHASSIS_DEADZONE` | 4 | 摇杆死区（%） |
| `CHASSIS_EXPO_PCT` | 0 | 指数曲线强度（0=线性） |
| `CHASSIS_MAX_PERMILLE` | 1000 | 解算输出满量程（‰） |
| `CHASSIS_INPUT_TIMEOUT_MS` | 300 | 底盘兜底超时（无新指令→输出 0） |
| `CHASSIS_LEFT/RIGHT_INVERT` | 0 | 左右轮逻辑方向 |
| `MOTOR_PWM_PERIOD_US` | 20000 | 电调周期（50Hz） |
| `MOTOR_PULSE_MIN/NEUTRAL/MAX` | 1000/1500/2000 | 电调脉宽（µs） |
| `MOTOR_ARM_DELAY_MS` | 3000 | 上电保持中位时长（给电调自检） |
| `MOTOR_LEFT/RIGHT_INVERT` | 0 | 左右电调信号方向（装反了改 1） |
| `TASK_CTRL/MOTOR/DBG/STAT_PERIOD_MS` | 10/20/100/1000 | 各时间片周期 |

---

## 5. 代码结构与后续扩展点

```
User/main.c          只做时间片调度，不放业务逻辑
Bsp/bsp_time.c       TIM2 1ms 时基 + BSP_Every() 软定时器
Bsp/bsp_uart.c       USART1 调试口 / USART3 遥控口（中断 + 环形缓冲）
Bsp/bsp_syscalls.c   newlib 裁剪（_write 也走非阻塞缓冲）
Bsp/bsp_motor.c      TIM3_CH1/CH2 → 两路电调 PWM
App/app_remote.c     协议解析 + 链路超时（链路层）
App/app_chassis.c    差速解算（运动层，换底盘只动这里）
App/app_config.h     所有可调参数
```

| 以后的功能 | 加在哪 | 怎么接 |
|---|---|---|
| 扫地（主扫/吸尘/边刷） | 新增 `App/app_cleaner.c` | 输出走新的 `Bsp/bsp_motor` 通道或独立 PWM 引脚 |
| 自动回充（红外寻桩+触点） | 新增 `App/app_charge.c` | 通过 `Chassis_SetInput()` 直接控底盘 |
| 避障（ToF/超声波） | 新增 `App/app_avoid.c` | 在 `main.c` 里串在遥控与底盘之间做仲裁 |
| OLED / WS2812 状态显示 | 新增 `App/app_ui.c` | 只读状态，不阻塞 |
| 电机编码器测速 | 新增 `Bsp/bsp_encoder.c` | TIM 编码器模式，PID 放 `app_chassis.c` |

---

## 6. ESP8266 端（Arduino）

工程：`esp8266/ESP8266_Blinker_Joy/ESP8266_Blinker_Joy.ino`（仓库内；本机 Arduino 草稿本里另有一份同样的）

| 项目 | 值 |
|---|---|
| 开发板 | Generic ESP8266 Module |
| Flash Size | 1MB (FS:none OTA:~502KB) |
| Crystal / CPU | 26MHz / 80MHz |
| 依赖库 | Blinker 0.3.10230510（库管理器，作者 i3water） |
| 编译占用 | Flash 504672 B (48%)，RAM 35952 B (44%)，IRAM 92% |
| 发送节奏 | 20ms 一帧（50Hz）；1s 收不到摇杆数据自动回中 |
| 调参开关 | `Y_INVERT` / `X_INVERT`（方向反了改 1）、`TEST_SWEEP`（1=不连 WiFi 只发扫描值） |

---

## 7. 激光雷达：YDLIDAR X2 兼容（数据链路 + 电脑点云 + 前向避障 ✅）

### 7.1 供电与接口（按原厂数据手册）

X2 的 4P 接口顺序是 **M_CTR / GND / Tx / VCC**。以 VCC 为第 1 脚往另一端数：

| 以 VCC 为起点 | 信号 | 接到哪里 |
|---|---|---|
| 1 | VCC | 独立 5V（启动瞬时峰值约 1A） |
| 2 | Tx | WCH-LinkE 的 **RX** |
| 3 | GND | 电源负极 + WCH-LinkE GND，必须共地 |
| 4 | M_CTR | 3.3V（或 0–3.3V / 10kHz PWM 调速）；**不是 RXD** |

> 卖家常把第 4 脚标成 RXD，这是错的。原厂 X2 数据手册第 3 页图 3 / 表 3 写的是 `M_CTR`。

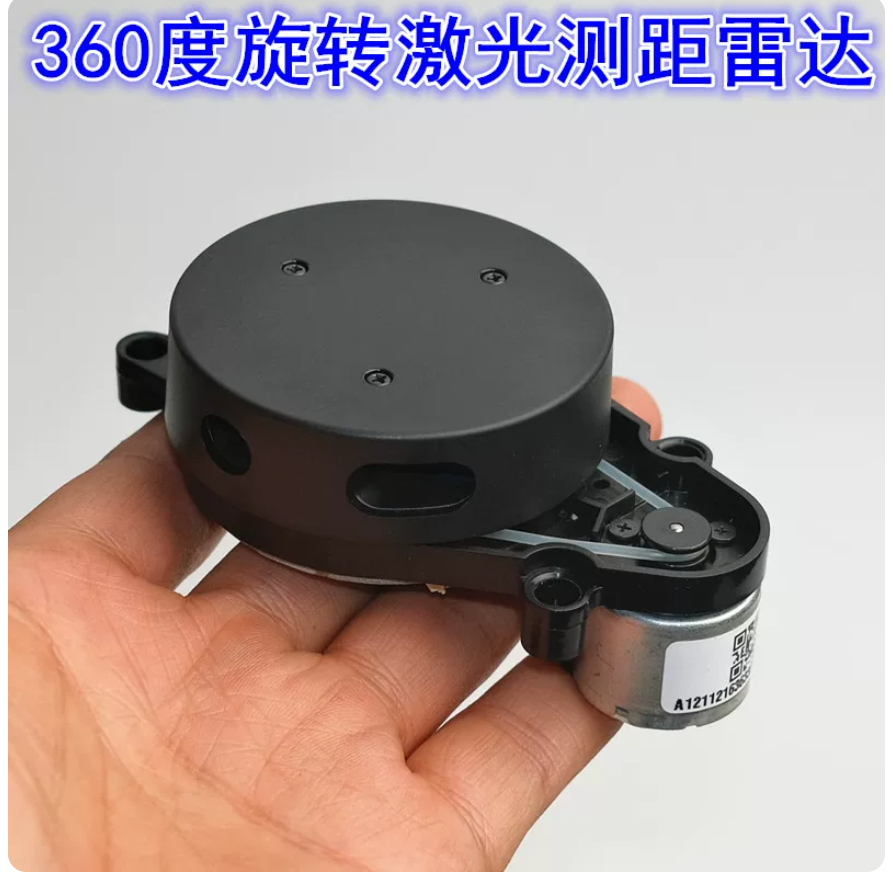
[picture p4: docs/images/20260919_16_lidar_x2_product.png]
X2 雷达产品图

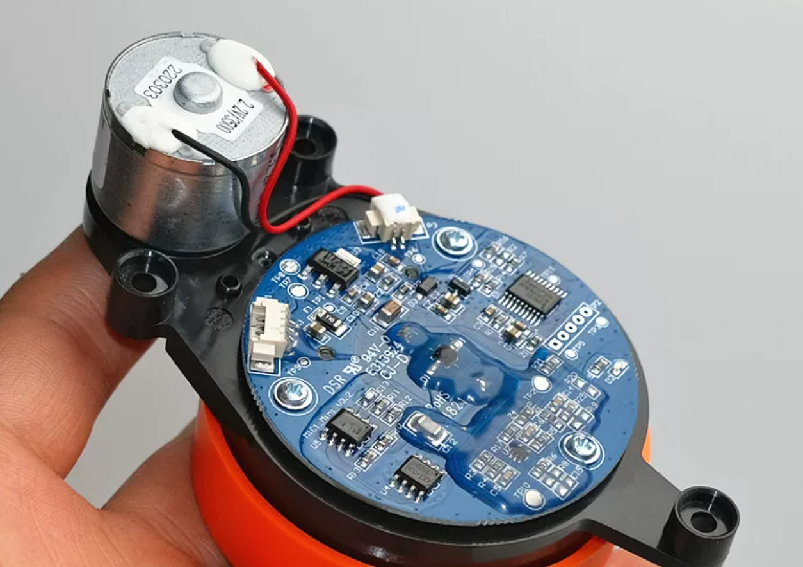
[picture p5: docs/images/20260919_18_lidar_wiring.png]
雷达接线实拍


### 7.2 电脑端验证结果

链路：`X2 Tx → WCH-LinkE RX → USB → COM6 @115200 → EaiLidarTest`。

| 验证项 | 实测结果 |
|---|---|
| 原始串口读取 | 3 秒 28615 字节，510 个 `AA 55` 帧头，约 9538 B/s |
| EaiLidarTest | 7.8 Hz / 4.18 K/s / 387(327) 点 |
| 2.56m 固定点 | 50 点，Min/Max 2559/2564，Std 1.5mm |

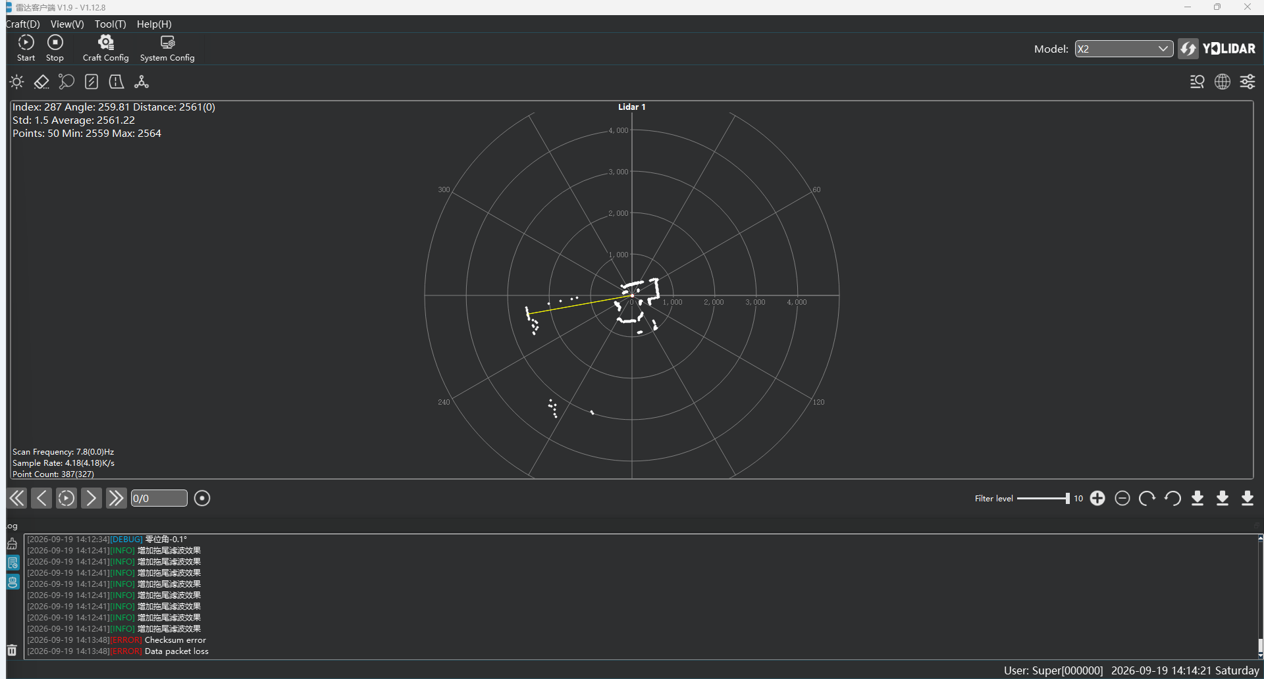
[picture p6: docs/images/20260919_22_eailidartest_com6_success.png]
EaiLidarTest 点云成功


### 7.3 踩坑：串口“打开成功”但读不到字节

* 现象：FTDI COM5 回环正常，EaiLidarTest 提示 `Automatic connection successful`，但 3 秒读不到一个字节，随后报 `Lidar disconnection` / `Operation timed out`。
* 根因：FTDI 的 RXD 没有真正接到 X2 的 Tx；卖家的“第 4 脚 RXD”标注也具有误导性。
* 解决：改用 WCH-LinkE-R0-1v3 的串口。Windows 识别为 `WCH-Link SERIAL (COM6)`，115200 直接读到 `AA 55` 数据。
* 结论：**不要只看“串口打开成功”**。用原始字节读一次最可靠；能读到 `AA 55` 才说明 Tx、GND、波特率都对了。

### 7.4 0° 正前方定义

原厂手册明确：**X2 的 0° 零方向在电机正前方**，也就是从旋转中心指向电机/接插件凸出的那一侧；角度顺时针增大。

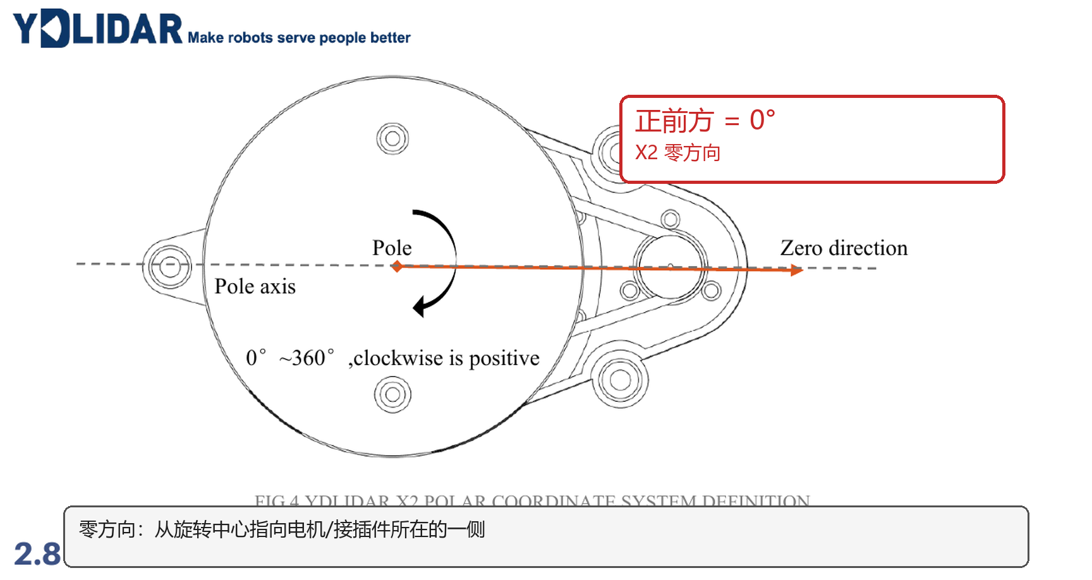
[picture p7: docs/images/20260919_x2_zero_direction.png]
X2 零方向定义


装车时雷达 0° 要朝车头。若实际安装不是 0°，可改 `App/app_config.h`：

* 雷达装反 180°：`AVOID_FRONT_OFFSET_CDEG = 18000`
* 车头在雷达 90° 方向：`9000`
* 车头在雷达 270° 方向：`27000`

### 7.5 前向避障实测（2026-09-19）

固件：`App/app_avoid.c` + `App/app_radar.c`，`AVOID_ENABLE=1`。测试时履带悬空，雷达接 CH32 PA3，COM4 读数如下：

| 操作 | `front` | `avoid` | 左右脉宽 | 结论 |
|---|---|---|---|---|
| 前方约 1m，推前进 | 1026–1049 mm | `CLEAR` | 2000/2000 µs | ✅ 满速前进 |
| 前方约 45–55cm，推前进 | 435–549 mm | `SLOW` | 约 1735–1970 µs | ✅ 随距离线性降速 |
| 前方约 22–30cm，推前进 | 221–307 mm | `STOP` | 1500/1500 µs | ✅ 前进被禁止 |
| 前方约 22cm，推后退 | 223 mm | `STOP` | 1000/1000 µs | ✅ 倒车仍允许 |
| 前方约 22cm，推右转 | 224 mm | `STOP` | 2000/1000 µs | ✅ 原地转仍允许 |
| 雷达拔掉/无数据 | 0 | `FAULT` | 1500/1500 µs（前进） | ✅ 失效保护 |

链路质量：`rx≈9400 B/s、ok≈168/s、csErr=0、fmtErr=0、ovf=0`。

> 说明：`front=0` 表示当前窗口没有有效前向回波，不是距离 0mm。避障只使用前向扇区，左右扇区目前只做预留。

---

## 8. 阶段六：树莓派上位机（进行中）

### 8.1 当前硬件与系统

| 项目 | 结果 |
|---|---|
| 主控 | Raspberry Pi 3 Model B+，1GB RAM，双频 WiFi |
| 底板 | 岚山 V1.61 3B/4B 地面端底板，XT60 6–28V 输入，5V 3A 级别 |
| 系统 | Raspberry Pi OS Lite (64-bit)，Debian 13 Trixie，kernel `6.18.50+rpt-rpi-v8` |
| 刷机 | Imager 2.0.11.1 两次崩溃；换 Imager 1.9.6 刷入成功 |
| 缓存镜像 | `D:\imager\raspios-lite-64bit.img.xz`（541 MB，XZ 校验通过） |
| 当前网络 | WiFi `miaomiaomao2.4G` → `192.168.1.5`（autoconnect）；Ethernet 备用 `192.168.1.213`；hostname `lintlizard` |
| SSH | 已 `active`；公钥免密登录已通（本机私钥 `~/.ssh/lintlizard_ed25519`），走 WiFi / Ethernet 均可 |
| AAT-1 | UART/TTL 3.3V，线序 `5V/GND/RX/TX`，对应 Pi GPIO14/GPIO15；接 CH32 时 RX/TX 交叉，5V 不接 |

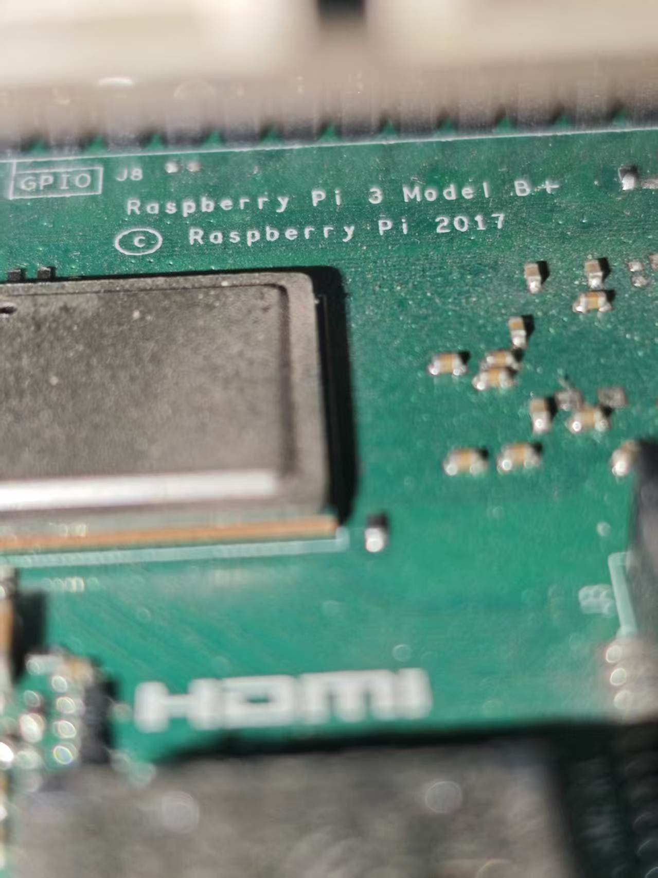
[picture p8: docs/images/20260919_rpi3bplus_board.jpg]
Raspberry Pi 3B+

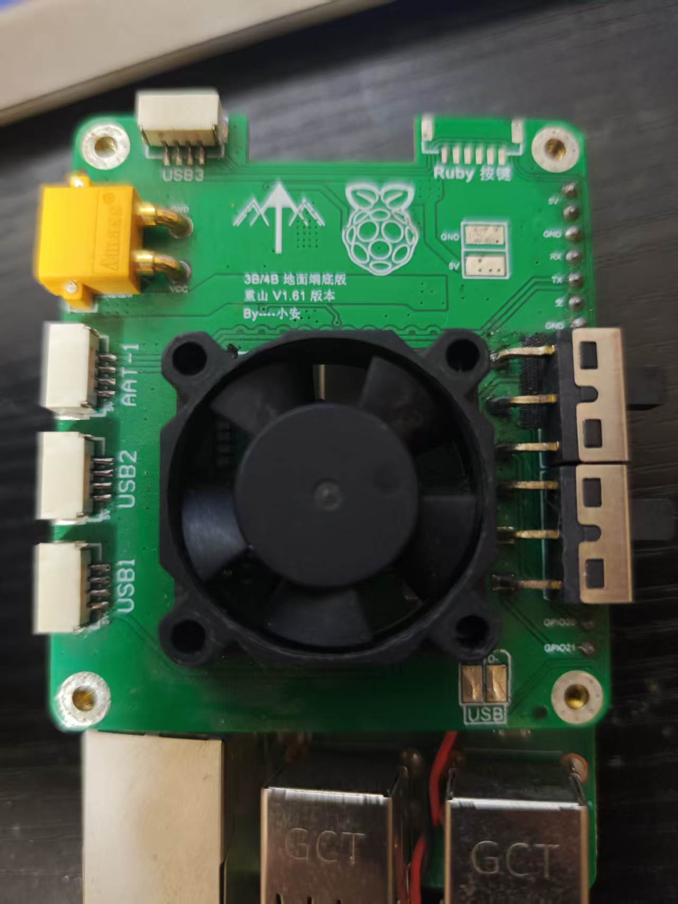
[picture p9: docs/images/20260919_rpi_baseboard_top.jpg]
岚山 V1.61 底板

AAT-1 的 TX/RX 位置
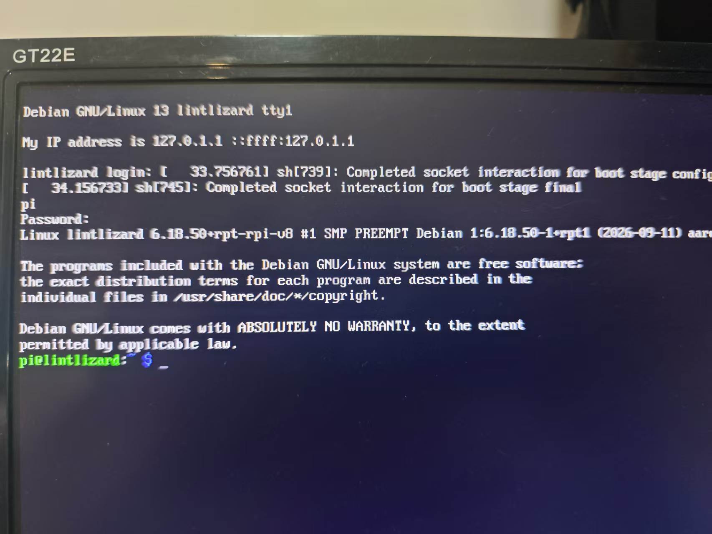
[picture p10: docs/images/20260919_rpi_console_login.jpg]
HDMI 控制台登录成功

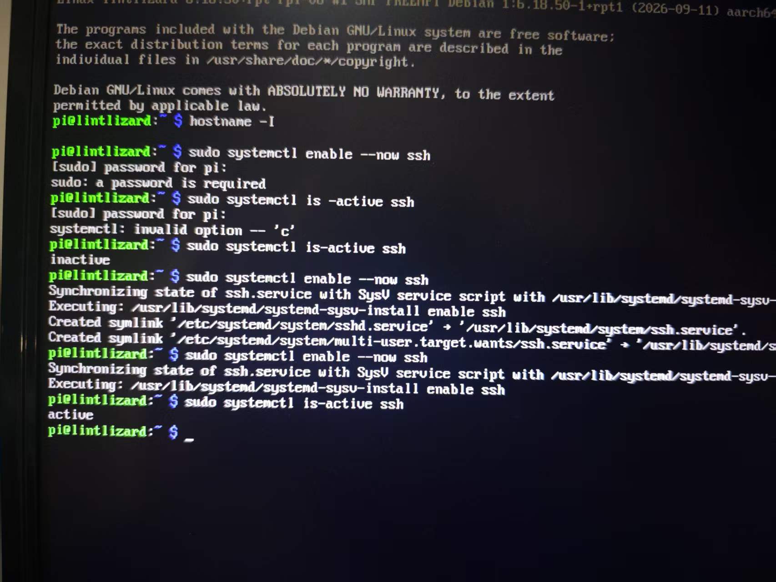
[picture p11: docs/images/20260919_rpi_ssh_active.jpg]
SSH 服务 active

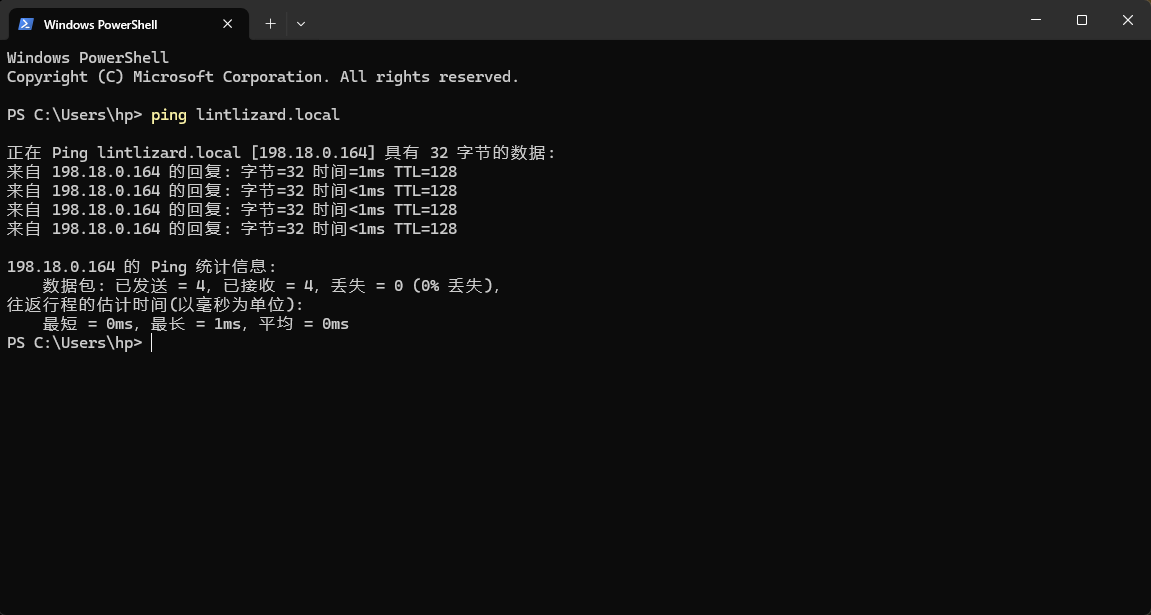
[picture p12: docs/images/20260919_rpi_ping_ip.png]
PC 扫描到树莓派真实 IP

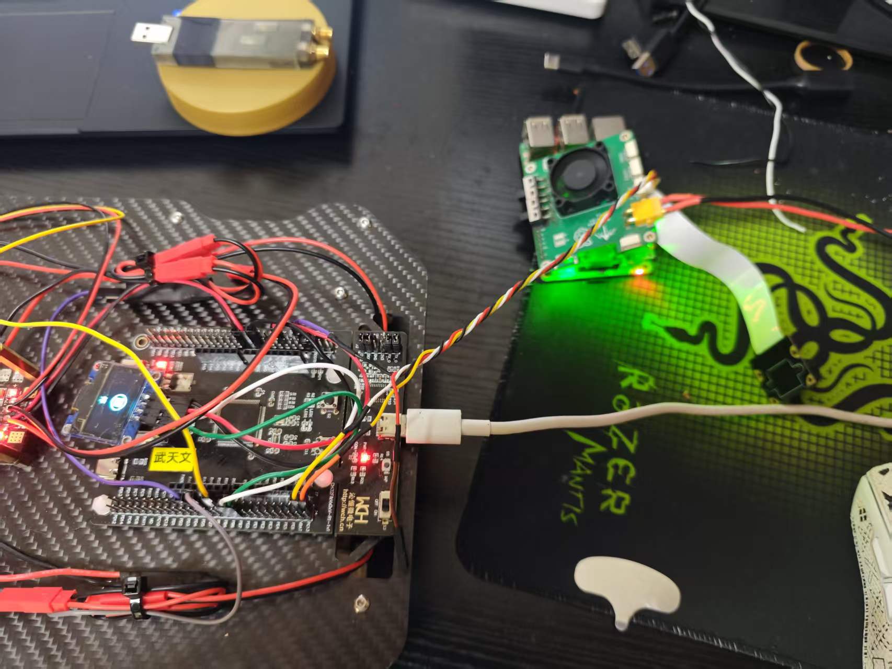
[picture p13: docs/images/20260922_02_lintlizard_rig.jpg]
整机实拍：CH32 底盘 + 树莓派 + CSI 摄像头 + AAT-1 互联


### 8.2 目前踩过的坑

* **Imager 2.0.11.1 崩溃**：错误在 `libstdc++-6.dll`，异常码 `0x40000015`；连续两次都在写卡阶段退出。换 Imager 1.9.6 + 已缓存镜像后写入成功。
* **读卡器掉线**：崩溃后 USB 读卡器从 Windows 消失；换 USB 口并让火绒信任 `D:\imager` 后恢复。
* **bootfs 无盘符**：写卡后 Windows 只看到两个分区，但 FAT32 `bootfs` 没有盘符；需要在磁盘管理里手动分配。
* **SSH 默认没开**：Raspberry Pi OS Lite 首次启动后 22 端口关闭；需要在 HDMI 控制台执行 `sudo systemctl enable --now ssh`。
* **Clash fake-IP**：`lintlizard.local` 被解析到 `198.18.0.164`，SSH 被 Clash TUN 当外网流量接走；实际用 `192.168.1.213` 直连。
* **中文 SSID**：Linux 控制台没有中文输入法，`妙妙喵-2.4G` 很难手动输入；已改为英文 2.4G SSID。注意路由器实际广播名是 `miaomiaomao2.4G`（末音节是 `mao` 不是 `miao`），5G 才是 `miaomiaomiao5G`，配 WiFi 时别打错。

### 8.3 下一步

1. ✅ 公钥免密登录已装好；✅ WiFi 已连 `miaomiaomao2.4G`（`192.168.1.5`，autoconnect）。
2. AAT-1 接 CH32：`GND → J4-7`、`RX → J4-1(PB10)`、`TX → J4-3(PB11)`、`5V` 不接。
3. Pi 侧启用 UART、关闭串口控制台，Pi 3B+ 建议加 `dtoverlay=disable-bt`。
4. CH32 侧把雷达原始数据转发到 USART3，同时接收 Pi 的 `{"x","y"}` 运动命令。
5. Pi 侧做 Web：CSI 摄像头 MJPEG + 雷达点云 + 虚拟摇杆 + 断线停车。

---

## 9. 版本记录

| 日期 | 内容 |
|---|---|
| 2026-09-14 | 接线表定稿（USART3 PB10/PB11）；ESP8266 Blinker 摇杆代码完成并编译通过 |
| 2026-09-14 | 阶段一完成：协议解析 + 差速解算 + COM4 打印，方向与失效保护实测通过 |
| 2026-09-15 | 电调模块 `bsp_motor.c` 完成：TIM3 50Hz/1000-2000µs，寄存器级验证 + 推杆实测通过 |
| 2026-09-15 | 建 GitHub 仓库 `tw-xy/LintLizard`（公开）+ CI 自动编译两端；WiFi/密钥拆进 `secrets.h`（已 gitignore） |
| 2026-09-15 | README 写清 LintLizard 的名字来历与当前阶段；**仓库名保留不改**（对应整机，不是当前阶段） |
| 2026-09-15 | 仓库收尾：修掉失效指代（`.ino` 注释 → `docs/接线表.md`、开发日志工程路径 → 仓库根）；出厂固件 `backup/` 入库（附 SHA256 + openocd 恢复命令）；CI 连续通过 |
| 2026-09-15 | 轮子转向验证通过；修「跑几秒就停」（EN 必须接 3.3V + 去掉"1 秒无数据即回中"的误判），实测按住 8 秒不掉速 |
| 2026-09-15 | **OLED 界面完成**：字模（11 个汉字 + 8 方向箭头 + 停止图标，`tools/gen_glyphs.py` 生成）、软件 I2C SSD1306 驱动、三态界面状态机；协议加 `net` 字段；屏幕实测 `oled=1`、状态机 `ui=direction` 跑通 |
| 2026-09-15 | **扫地执行机构代码完成**：边刷 EN（PE8/PE10，12V→5V 模块高电平启动）+ 吸尘电调（PB0 = TIM3_CH3，车动 1250µs / 车停 1000µs，停后延时 2 秒再关）；`[stat]` 增加 `clean=`/`vac=` 便于无硬件验证 |
| 2026-09-19 | 恢复开发：更新「当前状态」；待办 = 扫地接线 + 烧录验证 / 落地跑直线与原地转 / OLED 观感确认 |
| 2026-09-19 | **扫地执行机构实测通过**（含修正上电误启动 bug）；**涡轮风机 18kHz 缓启动**验证（日志里抓到 fan 0%→39%→0% 斜坡） |
| 2026-09-19 | **激光雷达验证通过**：雷达 TXD → CH32 的 PA3(J3-34)，`[rad]` 摘要 9424 B/s / 168 包每秒 / 25 点每包（约 4200 点/秒）、ovf=0；期间用 FTDI 回环测试排除了适配器问题 |
| 2026-09-19 | **PC 端点云验证通过**：WCH-LinkE COM6 + EaiLidarTest，7.8Hz / 4.18K/s / 387(327) 点；确认 X2 第 4 脚为 `M_CTR` 不是 RXD，FTDI 0 字节问题定位为接线/脚位而非适配器 |
| 2026-09-19 | **前向避障实测通过**：X2 点云完整解析 + 48 包滑动窗口；前进 1m 满速、45–55cm 降速、≤30cm 停车；有障碍倒车/原地转仍可用；雷达失效前进锁定；零方向图入库 |
| 2026-09-19 | **树莓派阶段硬件确认**：3B+ + 岚山 V1.61 地面端底板；AAT-1 由板卡设计者确认是 UART/TTL 3.3V，可直接接 CH32 PB10/PB11；5V 3A；WCH-LinkE 可当 USB-TTL |
| 2026-09-19 | AAT-1 线序确认：`5V/GND/RX/TX`，对应 Pi GPIO14(TXD)/GPIO15(RXD)；与 CH32 连接按 RX/TX 交叉，5V 不接 |
| 2026-09-20 | **树莓派系统刷入成功**：Imager 2.0.11.1 在 `libstdc++-6.dll` 崩溃两次；改用 Imager 1.9.6 + 缓存镜像，写入 Raspberry Pi OS Lite 64-bit (Trixie) |
| 2026-09-20 | **树莓派首次启动**：HDMI 控制台登录成功；Ethernet 获取 `192.168.1.213`，MAC `B8:27:EB:F6:89:75`，hostname `lintlizard`；SSH 服务已启用并 `active`，端口 22 可达 |
| 2026-09-20 | 已确认 Imager 版本、bootfs 盘符、Clash fake-IP、中文 SSID 控制台输入等坑；下一步收尾 SSH 登录并接 AAT-1 |
| 2026-09-21 | **树莓派 SSH 免密 + WiFi 收尾**：`pi` 公钥免密登录装好（`~/.ssh/authorized_keys`）；2.4G SSID 改为英文后实测为 `miaomiaomao2.4G`（非 `miao`），WiFi 已连上并 autoconnect（IP `192.168.1.5`）；走 WiFi/Ethernet 均能 SSH |
| 2026-09-21 | **树莓派 WiFi-only 验证通过**：拔掉网线后仅靠内置 `wlan0` 联网（IP `192.168.1.5`，`eth0` = unavailable），电脑 IPv4 SSH 稳定连通；期间定位到 **Clash TUN 劫持局域网 IPv4**（症状：IPv4 超时 / IPv6 通 / ARP 通），关 TUN 后恢复 |
| 2026-09-22 | **树莓派 ↔ CH32 串口链路打通**：Pi 侧启用 UART（`enable_uart=1` + `dtoverlay=disable-bt`，重启后 `/dev/serial0 -> ttyAMA0`）；从 Pi 发 `{"x":50,"y":80}`，CH32 USART3 完整收到（`LINK-OK`、9~10 帧/秒、frames 74、`L=+500 R=-500`）；停止后 300ms 失效保护回 `1500/1500`。因雷达未接 `avoid=FAULT` 锁前进，仅输出转向分量 |
| 2026-09-22 | **树莓派 Web 控制台上线**：`pi/server.py`（纯标准库、零安装）提供虚拟摇杆 + 摄像头 MJPEG + 点云接口；实测浏览器发指令 → CH32 `LINK-OK`（8 帧/秒、解算正确），停发后 watchdog 补发 `x=0,y=0`；OV5647 CSI 摄像头识别成功，6 秒抓 73 帧（~12fps）；`lintlizard-web.service` 开机自启；顺手关掉 WiFi 省电（此前两次掉线的元凶） |
| 2026-09-22 | **雷达网页数据链路软件完成，待实机**：CH32 已校验/修正的点每 8 点抽 1 点，经 USART3 发 `R,angle_cdeg,dist_mm`；环形缓冲整行接纳，满时直接丢弃并统计。Pi 接收处理分包/粘包/坏行，按度保存、0.5s 清理旧点，网页显示在线状态。固件编译通过（FLASH 27332B / RAM 6084B）；Pi 7 项测试（含 PTY 双向串口与 HTTP）和 C 解析器测试通过，加入 CI。Pi 服务已部署并确认 active、串口 open、camera=true。用户确认雷达未接线，目前 CH32 rx=0 B/s；**尚未烧录、尚未验证真实点云**。旧 Pi 服务已备份为 `/home/pi/lintlizard-server.py.before-radar-20260922`；sudo 重启需密码，使用 pi 用户结束自己的服务进程后由 systemd Restart=always 自动拉起成功。 |
| 2026-09-22 | **真实网页点云实测完成**：用户接好雷达后，旧固件确认约 9400 B/s；提醒覆盖后通过 WCH-LinkE 烧录新固件，OpenOCD Verified OK。Pi `/scan` 在线并持续更新，5.33s 采样约 408.7 点/秒、140–177 个新鲜点、invalid 增量 0；同时发送 50 条回中指令，COM4 LINK-OK、err=0、rxovf=0、电调 1500/1500µs、roam=IDLE。CH32 转发启动初期丢弃 6 点，后续累计不增，雷达 csErr/fmtErr/ovf 均为 0。浏览器确认摄像头与绿色点云同时显示；截图归档。未进行非零摇杆或落地行驶测试。 |
| 2026-09-22 | **WASD 键盘驾驶上线**：保留虚拟摇杆，新增W前进/S后退/A左转/D右转、组合键归一化、按键高亮、默认50%可调速度、空格/Esc停车；松键/失焦/隐藏/触控取消回中，100ms心跳。网页所有串口指令加manual=1，CH32纯手动分支解决旧巡航的全后退急停与回中后自动前进冲突；旧ESP巡航保留。HTTP session/seq防迟到旧指令覆盖停车，失败清除输入。固件编译（FLASH27416B/RAM6084B）与烧录校验通过，网页已部署；8项Python/PTY、JS控制事件、C手动/巡航测试通过。实车只发回中：LINK-OK 10帧/秒，err=0、rxovf=0、roam=IDLE，电调1500/1500µs；摄像头/雷达正常，未做实车非零方向测试。Pi备份为`/home/pi/lintlizard-server.py.before-wasd-20260922`。 |
| 待办 | ① 键盘/摇杆实际行驶及落地直线、原地转验证 ② 网页登录验证 / 远程访问（按用户选择） ③ 避障阈值/扇区精调 ④ 编码器 + IMU（暂缓采购） ⑤ 扫地机拆机主刷/滚刷电机选型 |

---

## 10. 开发过程图集

> 下面图片来自开发过程中用户提供的截图与实拍，已复制到 `docs/images/`，按时间顺序编号。

### 9.1 工具与 ESP8266

| 图片 | 说明 |
|---|---|
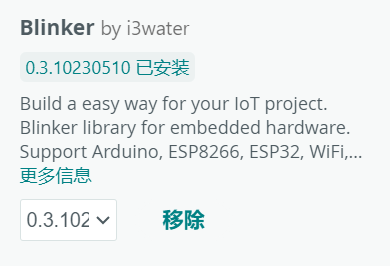
[picture p14: docs/images/20260914_01_blinker_library.png]
|  | Blinker 库安装完成 |
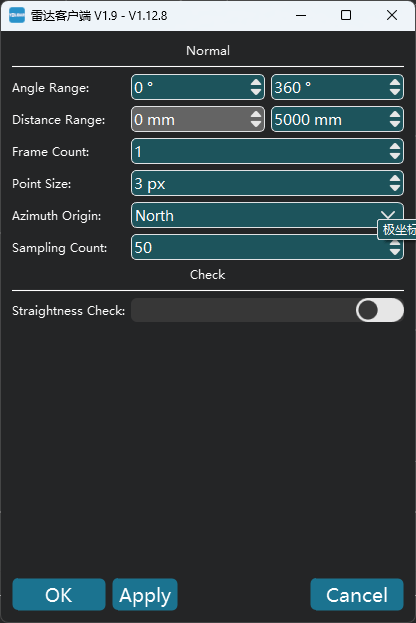
[picture p15: docs/images/20260919_20_arduino_esp8266_board.png]
|  | Arduino 开发板管理器：ESP8266 包 |

### 9.2 树莓派 CM4 刷机过程

| 图片 | 说明 |
|---|---|
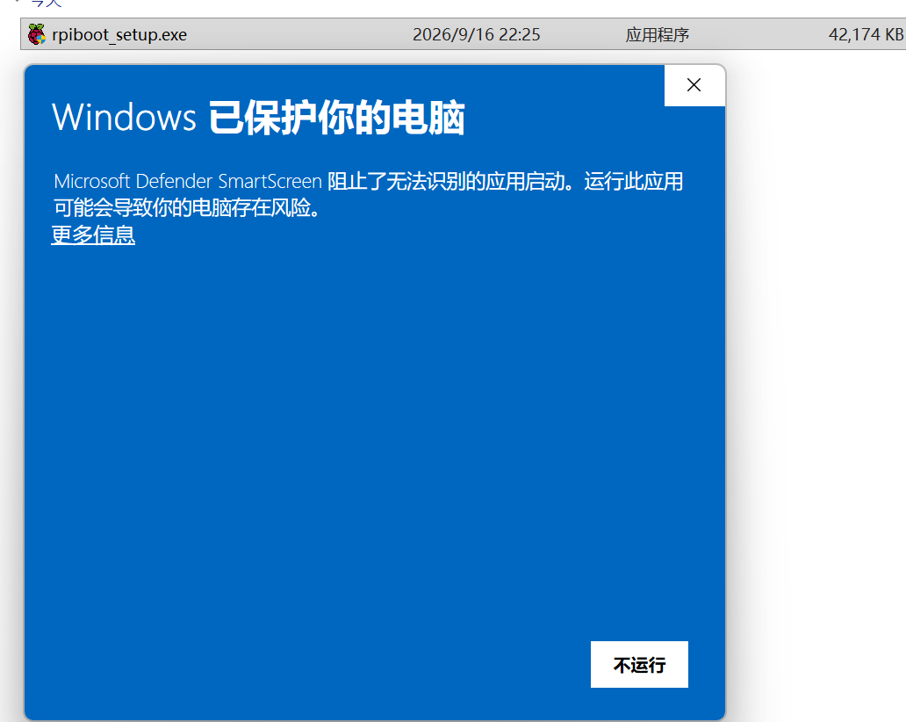
[picture p16: docs/images/20260916_02_windows_smartscreen.png]
|  | Windows SmartScreen 拦截安装程序 |
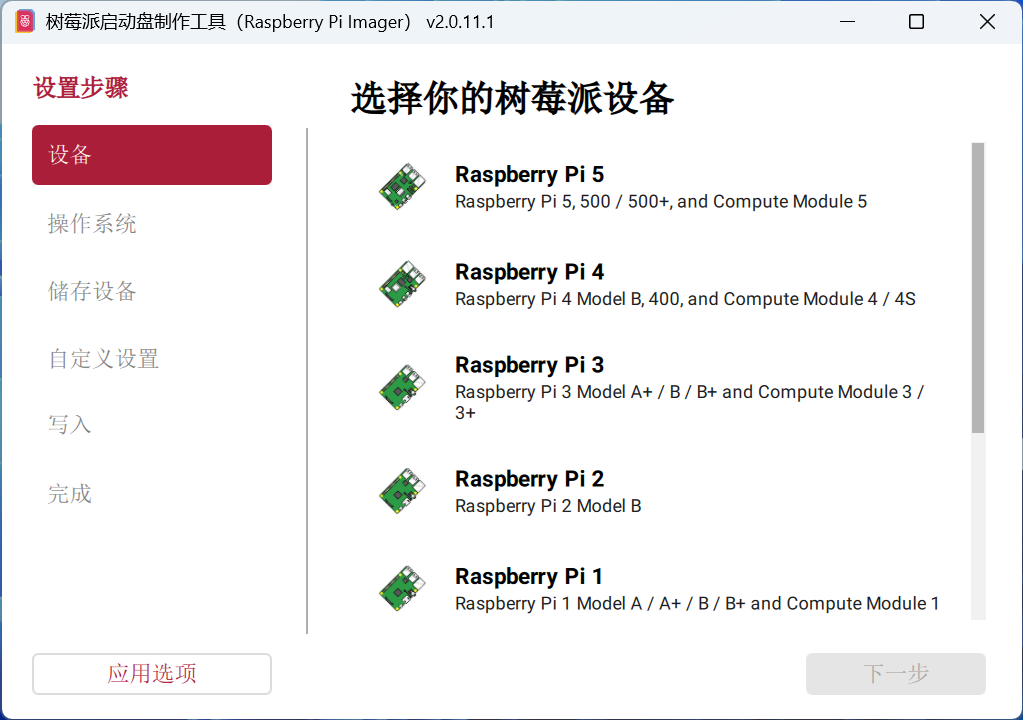
[picture p17: docs/images/20260916_03_rpi_imager_device.png]
|  | rpi-imager：选择设备 |
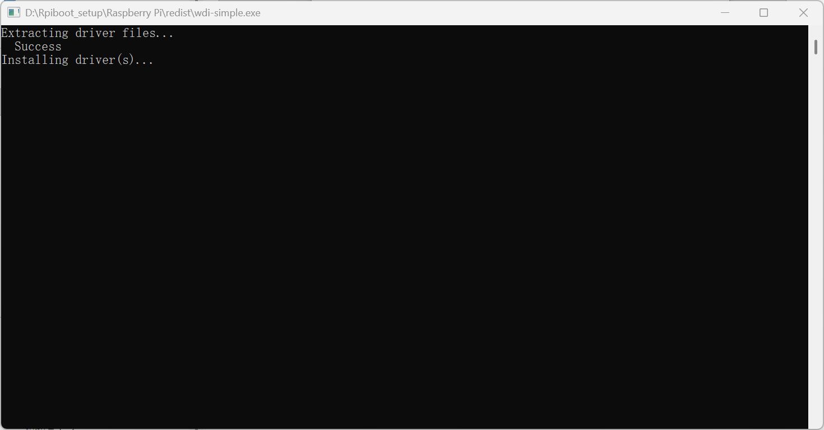
[picture p18: docs/images/20260916_04_rpiboot_driver_install.png]
|  | rpiboot 驱动安装成功 |
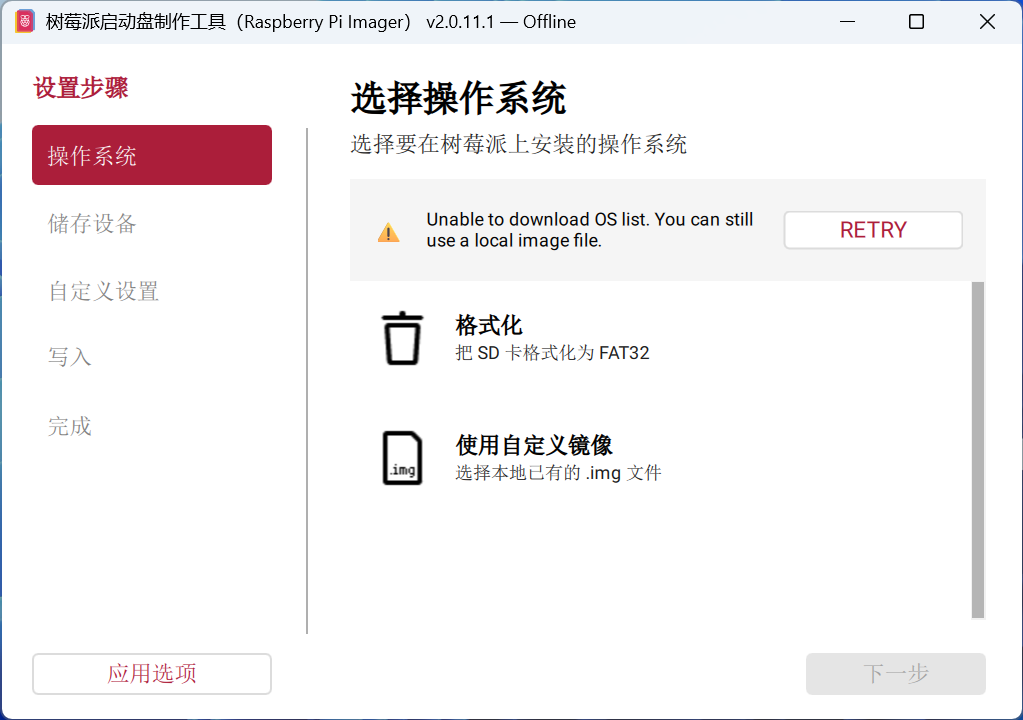
[picture p19: docs/images/20260916_05_rpi_imager_os.png]
|  | rpi-imager：选择 Raspberry Pi OS |
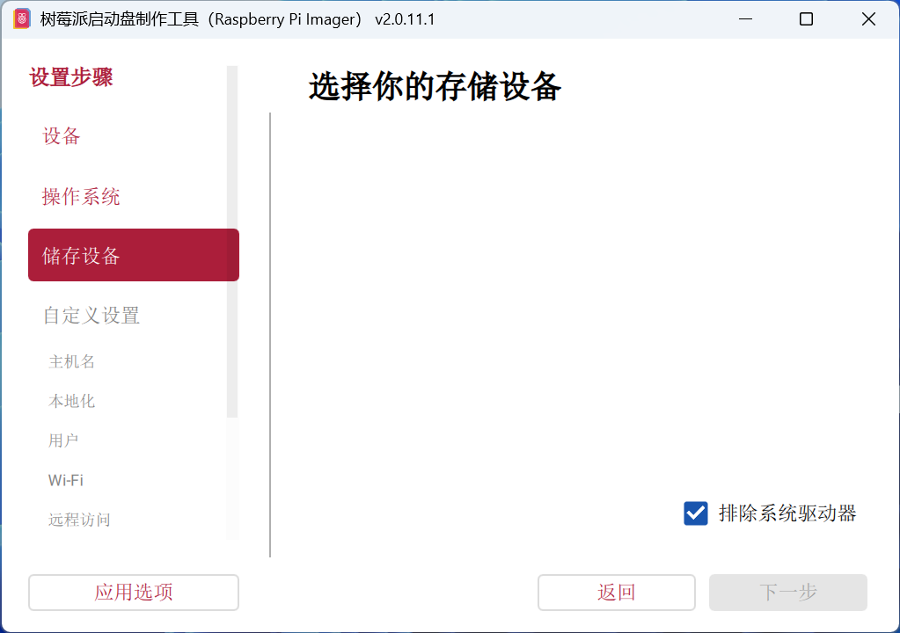
[picture p20: docs/images/20260916_06_rpi_imager_storage.png]
|  | rpi-imager：选择存储设备 |
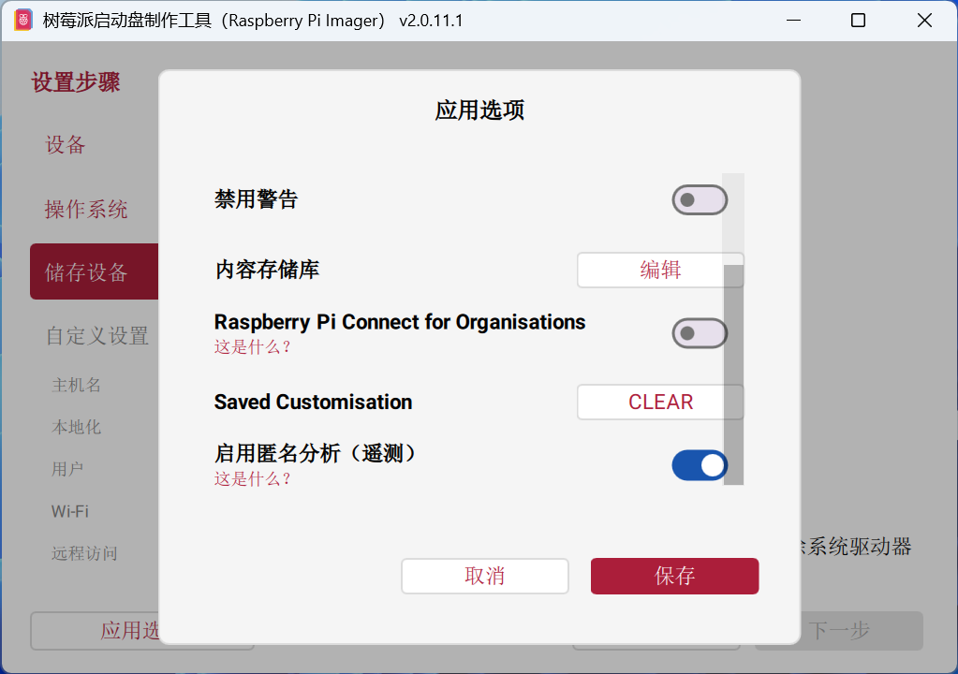
[picture p21: docs/images/20260916_07_rpi_imager_apply.png]
|  | rpi-imager：应用自定义设置警告 |
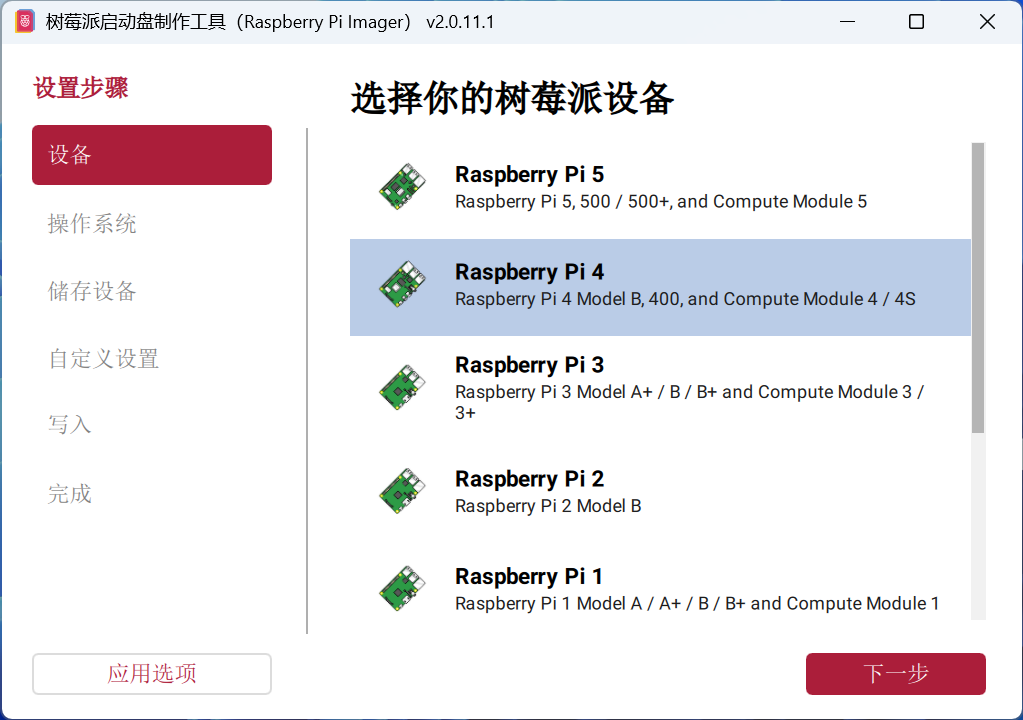
[picture p22: docs/images/20260916_08_rpi_imager_device_2.png]
|  | rpi-imager：设备选择重复截图 |
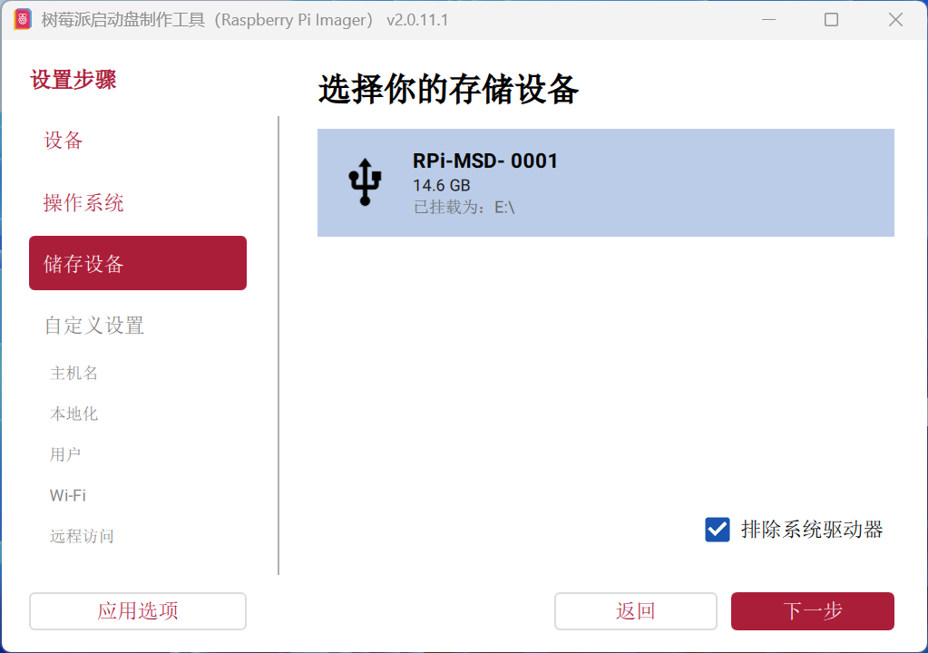
[picture p23: docs/images/20260916_09_rpi_imager_storage_2.png]
|  | rpi-imager：存储设备重复截图 |
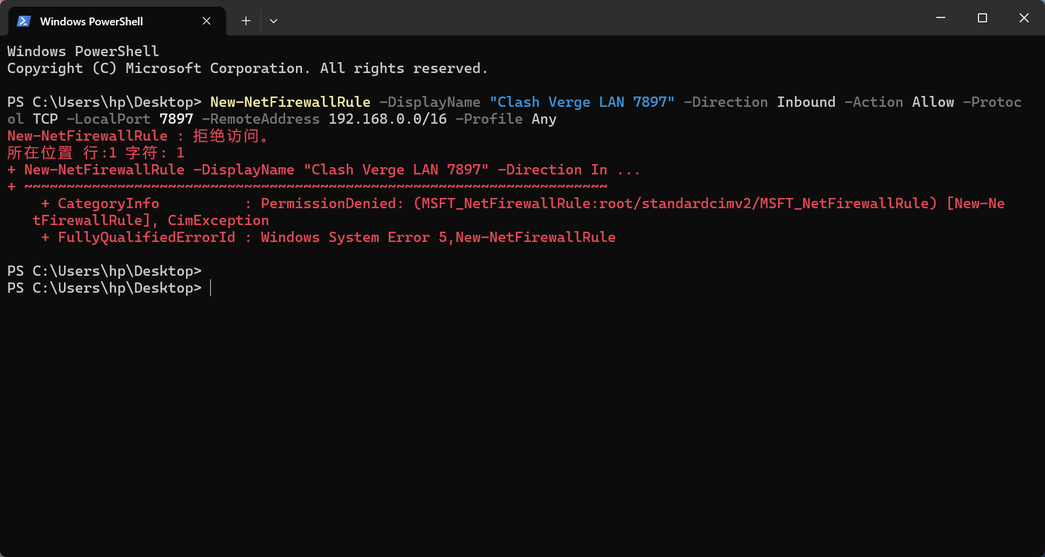
[picture p24: docs/images/20260916_10_firewall_rule_denied.png]
|  | PowerShell 加防火墙规则被拒绝 |
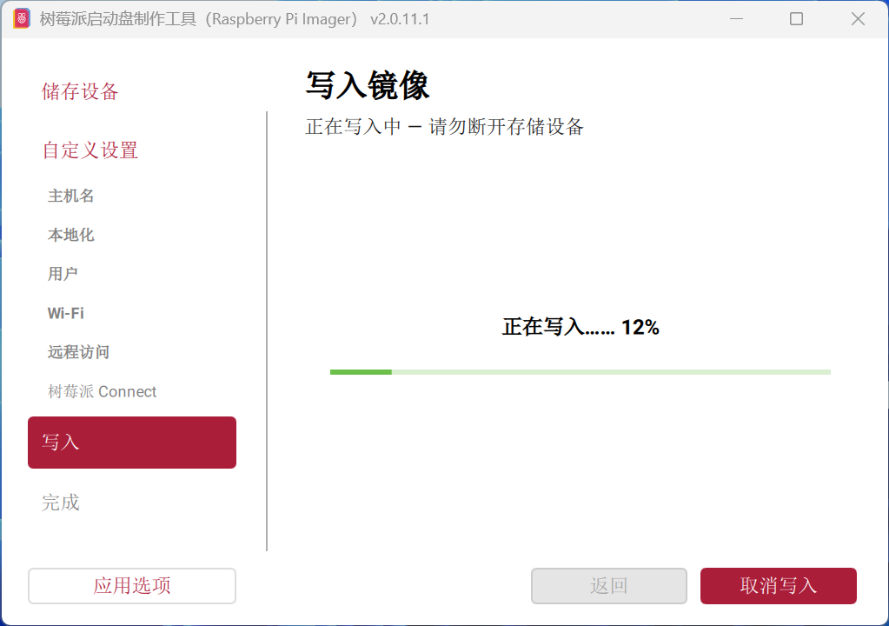
[picture p25: docs/images/20260916_11_rpi_imager_writing.png]
|  | rpi-imager：写入 12% |
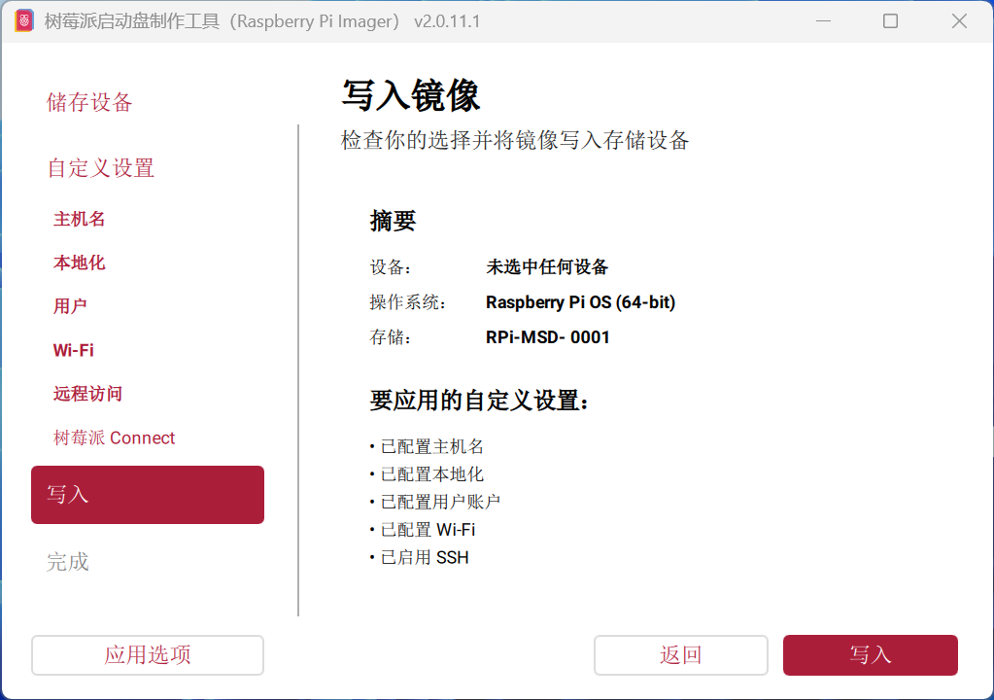
[picture p26: docs/images/20260916_12_rpi_imager_write_done.png]
|  | rpi-imager：写入进度 |
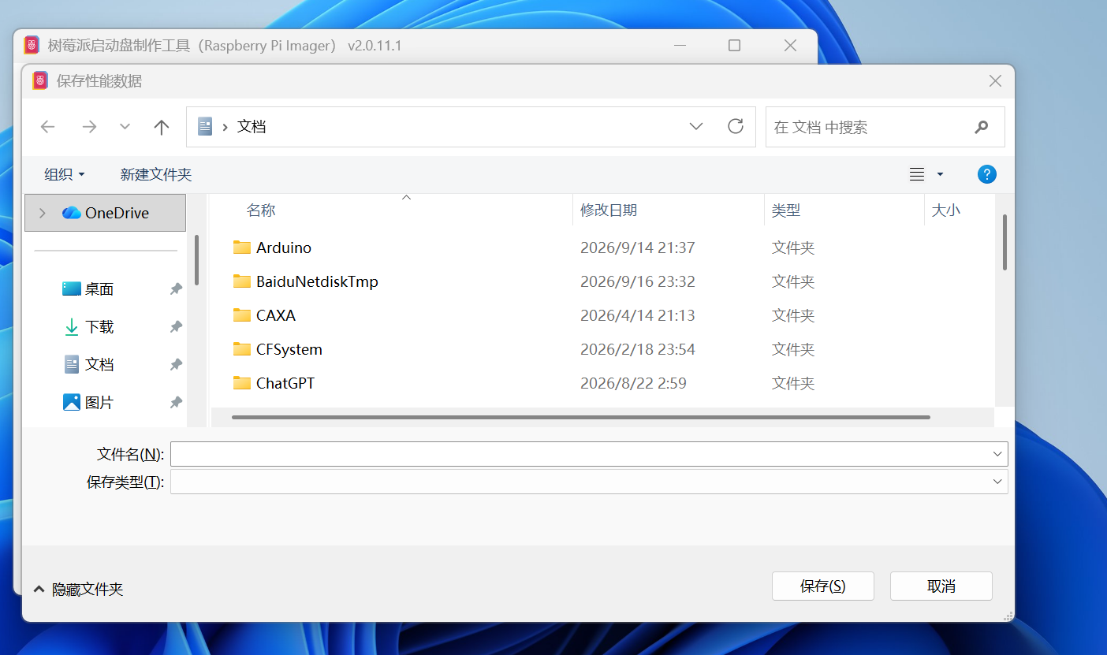
[picture p27: docs/images/20260916_13_save_dialog.png]
|  | 保存性能数据的文件对话框 |

### 9.3 扫地执行机构

| 图片 | 说明 |
|---|---|
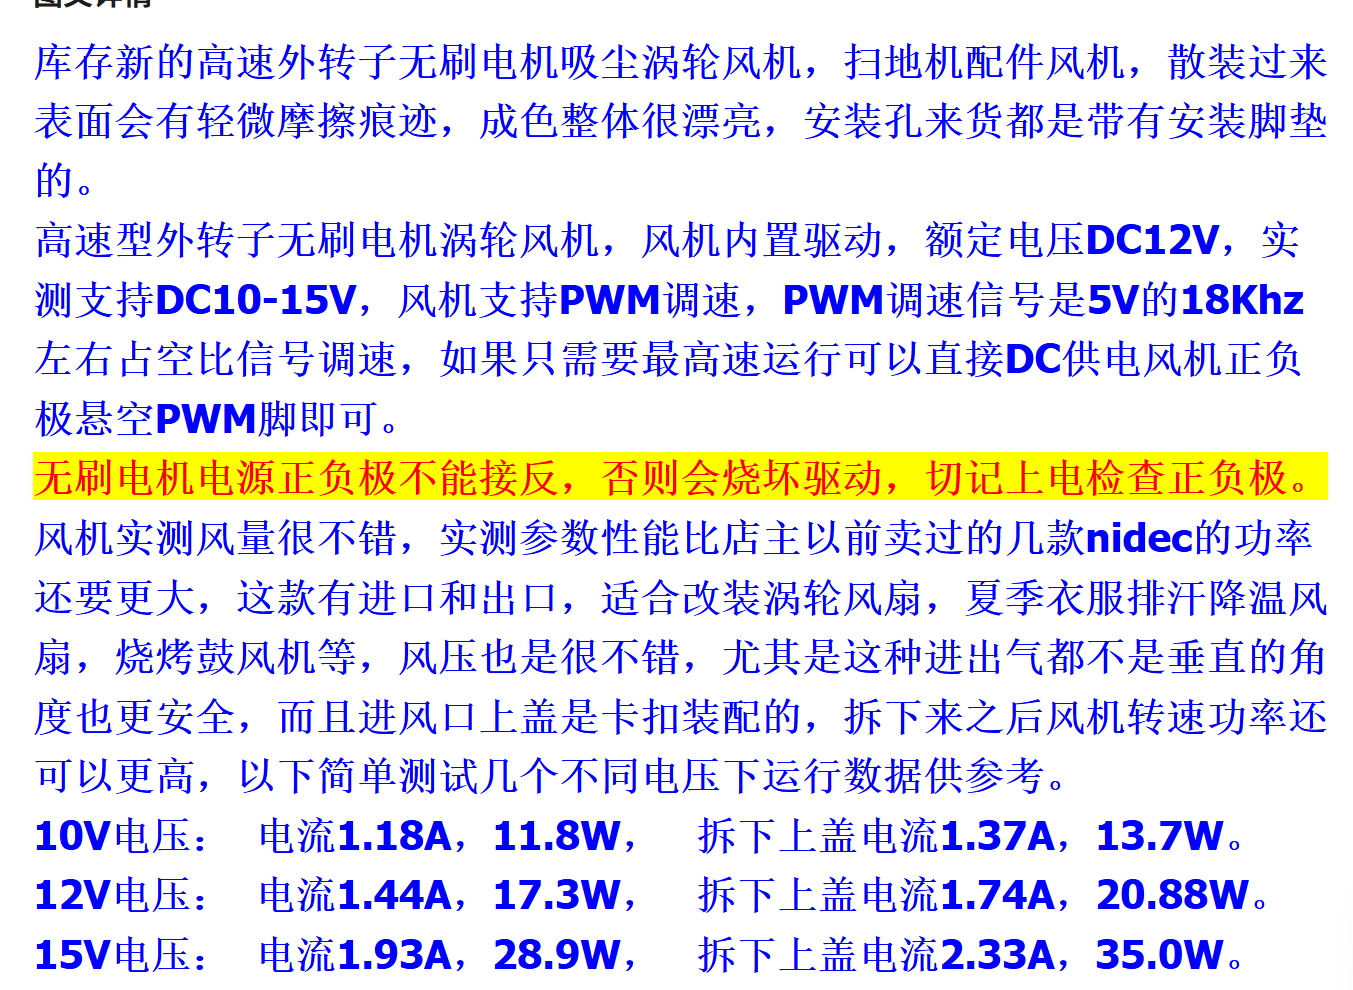
[picture p28: docs/images/20260919_14_fan_spec.png]
|  | 涡轮风机规格与 PWM 说明 |
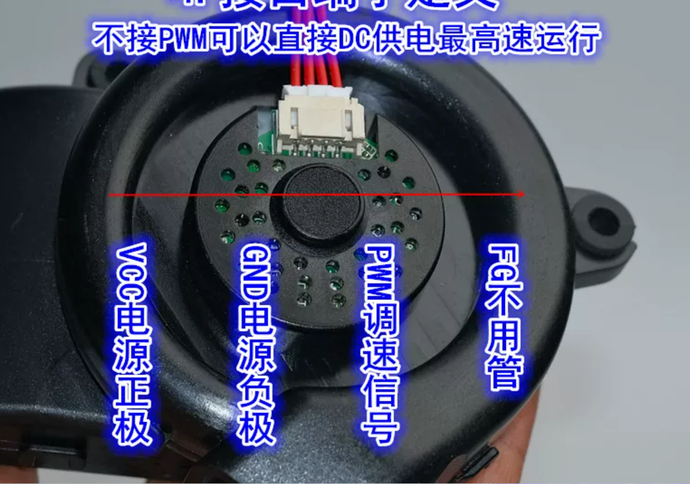
[picture p29: docs/images/20260919_15_fan_wiring.png]
|  | 涡轮风机接线标注：红线不接 |

### 9.4 激光雷达

| 图片 | 说明 |
|---|---|
|  | YDLIDAR X2 兼容雷达实物 |
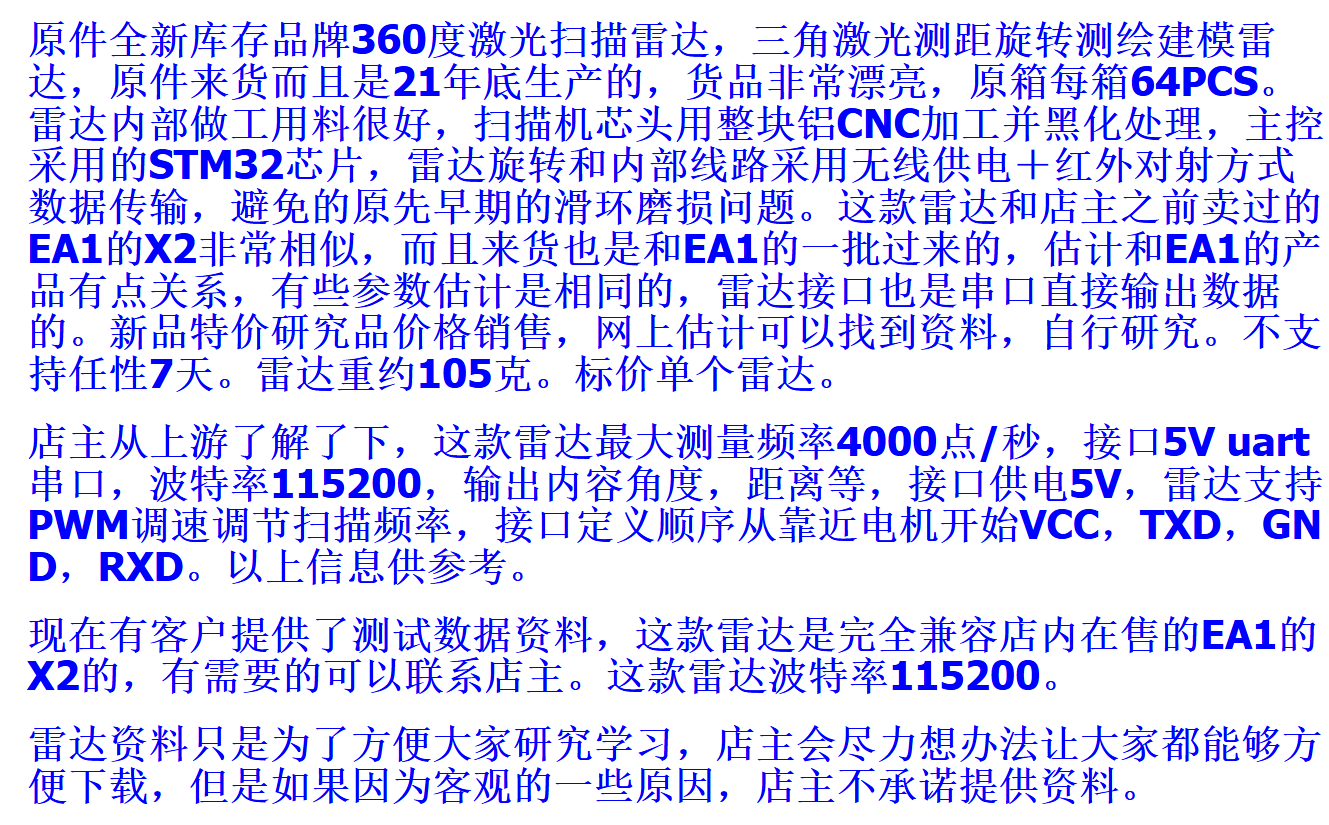
[picture p30: docs/images/20260919_17_lidar_listing.png]
|  | 卖家商品说明：115200 / 4000 点/秒 |
|  | 雷达接线实拍 |
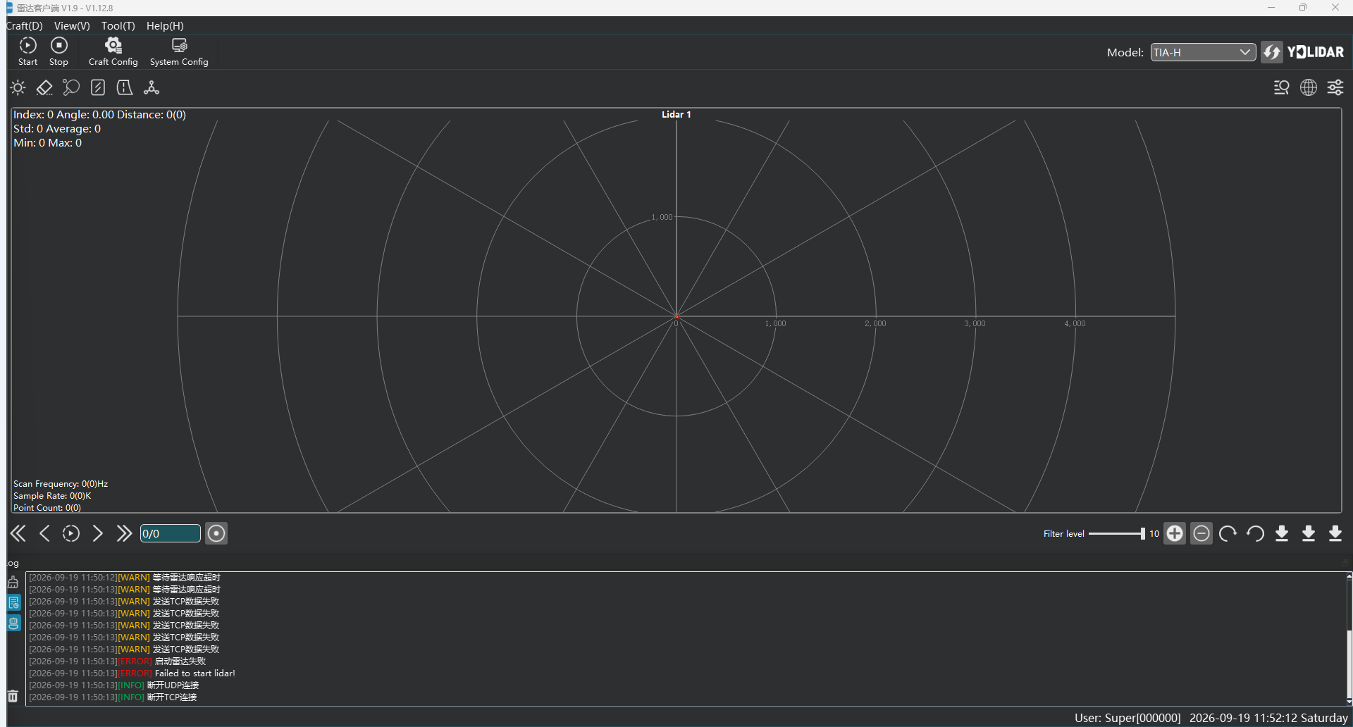
[picture p31: docs/images/20260919_19_eailidartest_empty.png]
|  | EaiLidarTest 无点云（排错前） |
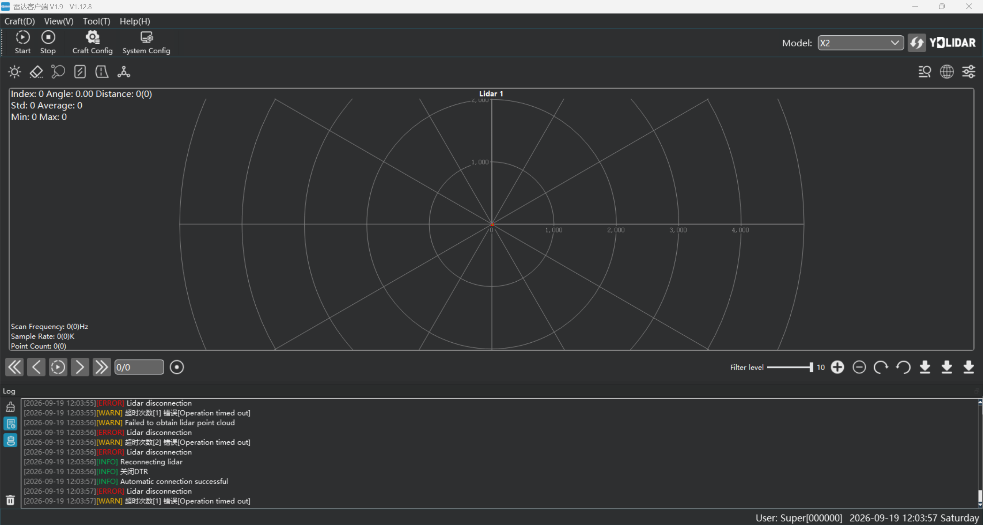
[picture p32: docs/images/20260919_21_eailidartest_com5_timeout.png]
|  | COM5 `Automatic connection successful` 但仍超时 |
|  | WCH-LinkE COM6 点云成功 |
|  | X2 0° 正前方定义（原厂手册 FIG 4 标注） |

### 9.5 树莓派上位机（Web 控制台）

| 图片 | 说明 |
|---|---|
|  | 整机实拍：CH32 底盘 + 树莓派（CSI 摄像头 + 散热风扇）+ AAT-1 互联 |
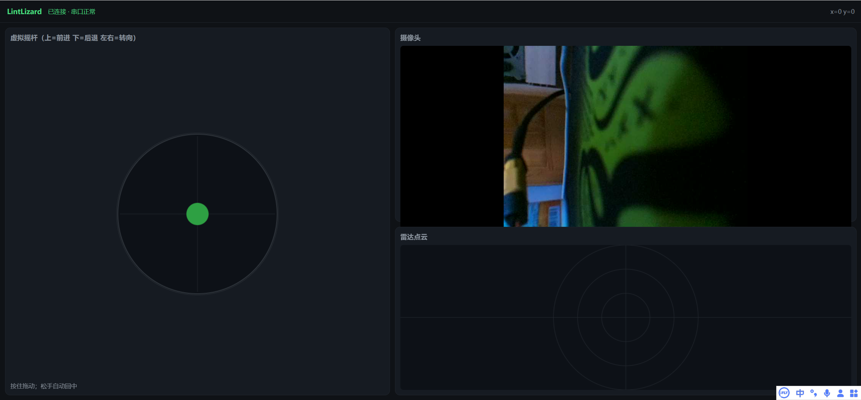
[picture p33: docs/images/20260922_01_web_control.png]
|  | Web 控制台实测：虚拟摇杆 + 摄像头 MJPEG 画面 + 点云面板（待固件接入） |
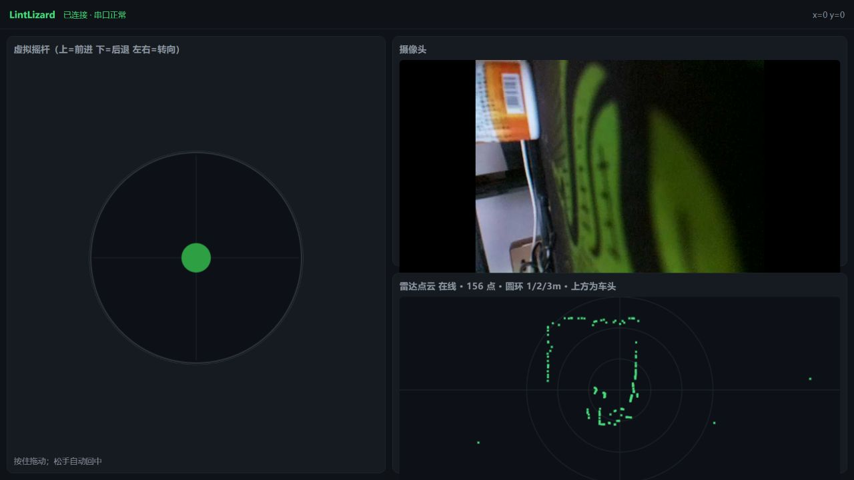
[picture p34: docs/images/20260922_03_web_radar_live.png]
|  | 新固件烧录后：真实雷达绿色点云与摄像头同时显示，摇杆回中静态联调 |
|  | 用户提供的完整控制台截图：串口正常、摄像头画面、雷达在线 152 点；同步展示于 README |
|  | WASD 键盘驾驶、速度滑块和停车按钮上线；摄像头及雷达正常，静态回中验证 |
