tw-xy/LintLizard/App/app_glyphs.h

/* 自动生成：tools/gen_glyphs.py（不要手改）
 * 格式：行优先，每字节 8 个水平像素，MSB 在左，1 = 点亮
 */
#ifndef __APP_GLYPHS_H
#define __APP_GLYPHS_H

#include <stdint.h>

/* cn_65E0  16x16 */
static const uint8_t cn_65E0[] = {
    0x00, 0x00, 0x1F, 0xF8, 0x01, 0x00, 0x01, 0x00, 0x01, 0x00, 0x01, 0x00,
    0x7F, 0xFE, 0x03, 0x40, 0x02, 0x40, 0x02, 0x40, 0x06, 0x40, 0x0C, 0x42,
    0x18, 0x46, 0x70, 0x7C, 0x00, 0x00, 0x00, 0x00,
};

/* cn_7F51  16x16 */
static const uint8_t cn_7F51[] = {
    0x00, 0x00, 0x7F, 0xFE, 0x60, 0x06, 0x61, 0x16, 0x7B, 0x16, 0x6A, 0xD6,
    0x66, 0x76, 0x66, 0x26, 0x66, 0x76, 0x6F, 0x76, 0x68, 0xDE, 0x70, 0x86,
    0x60, 0x06, 0x60, 0x0C, 0x00, 0x00, 0x00, 0x00,
};

/* cn_7EDC  16x16 */
static const uint8_t cn_7EDC[] = {
    0x00, 0x00, 0x10, 0xC0, 0x10, 0xFC, 0x25, 0x8C, 0x6D, 0x48, 0x7A, 0x70,
    0x58, 0x70, 0x11, 0xDC, 0x23, 0x86, 0x7C, 0xFC, 0x00, 0x8C, 0x04, 0x8C,
    0x7C, 0xFC, 0x20, 0x8C, 0x00, 0x80, 0x00, 0x00,
};

/* cn_5DF2  16x16 */
static const uint8_t cn_5DF2[] = {
    0x00, 0x00, 0x3F, 0xF8, 0x00, 0x08, 0x00, 0x08, 0x00, 0x08, 0x30, 0x08,
    0x3F, 0xF8, 0x30, 0x08, 0x30, 0x00, 0x30, 0x00, 0x30, 0x00, 0x30, 0x06,
    0x30, 0x06, 0x1F, 0xFC, 0x00, 0x00, 0x00, 0x00,
};

/* cn_8FDE  16x16 */
static const uint8_t cn_8FDE[] = {
    0x00, 0x00, 0x20, 0xC0, 0x37, 0xFE, 0x11, 0x80, 0x01, 0x20, 0x03, 0x60,
    0x73, 0xFC, 0x10, 0x20, 0x10, 0x20, 0x17, 0xFE, 0x10, 0x20, 0x10, 0x20,
    0x3C, 0x20, 0x47, 0xFE, 0x00, 0x00, 0x00, 0x00,
};

/* cn_63A5  16x16 */
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
    0x00, 0x00, 0x00, 0x00, 0x00, 0x00, 0x00, 0x00, 0x00, 0x00, 0x00, 0x00,
    0x00, 0x00, 0x00, 0x00, 0x00, 0x00, 0x00, 0x00,
};

typedef struct
{
    uint8_t        w;
    uint8_t        h;
    const uint8_t *data;
} Glyph;

#endif /* __APP_GLYPHS_H */
