tw-xy/LintLizard/(commit log)

2026-09-15 初始提交：CH32V307 履带小车（Blinker 遥控 + 差速解算 + 双电调 PWM）
    固件（User/Bsp/App）：非阻塞时间片（TIM2 1ms 时基 + BSP_Every 软定时器，无 Delay_Ms）；USART1 调试口 / USART3 遥控口全中断 + 环形缓冲；行协议解析（只认 { 开头的行）+ 链路超时；标准差速转向（死区/归一化/失效保护）；TIM3_CH1/CH2 50Hz / 1000-2000us 双电调输出
    ESP8266 端：Blinker 虚拟摇杆 -> 50Hz JSON 串口发送（WiFi/密钥在 secrets.h，已被 gitignore）
    工具与资料：build.ps1 / flash.ps1 / log.ps1；随仓库自带 sdk/；docs 含接线表、避坑Checklist、编译环境、开发日志、下一步AI提示词
2026-09-15 加 CI：push 后自动编译（方案 B）
    GitHub Actions 两个 job：CH32V307 固件（xpack riscv-none-embed-gcc 8.3.0 + 仓库自带 sdk/）和 ESP8266 sketch（arduino-cli + esp8266 core 3.1.2 + Blinker 0.3.10230510，用 secrets.h.example 生成临时 secrets.h）。
    同时新增跨平台 build.sh（Linux/macOS/CI 用，与 build.ps1 同参数），编译产物作为 artifact 上传。
2026-09-15 修 CI: arduino-cli 改成直接下 release 包
    install.sh 要求 BINDIR 目录预先存在，全新 runner 上会直接失败；改为下载 arduino-cli_1.5.1_Linux_64bit.tar.gz 并解到 ~/.local/bin。
2026-09-15 README 加 CI 状态徽章
2026-09-15 文档：写清楚 LintLizard 是什么、名字来历与当前阶段
    README 开头说明 LintLizard = Lint(毛絮)+Lizard(蜥蜴)，这台履带扫地机器人的固件仓库，目前处于第一阶段（遥控底盘）；开发日志新增「关于名字」小节并把仓库/CI 记进版本记录；编译环境补上 build.sh 与 GitHub Actions。
2026-09-15 收尾：修掉失效指代 + 出厂固件备份入库
    1) ESP8266 sketch 注释里的「详见聊天里的接线表」改成指向 docs/接线表.md；2) 开发日志头部工程路径改成「本仓库根目录」，ESP 工程路径改成仓库内相对路径；3) backup/ 存放出厂固件备份（294912B，附 SHA256 与 openocd 恢复命令），.gitignore 放行 backup/*.bin。
    其余按「仓库是给自己看的」原则不动：LICENSE、文档里的本机路径、.project 绝对路径、脚本硬编码工具链路径都保持现状。
2026-09-15 开发日志：加「当前状态」总览 + 补齐版本记录
    顶部新增「当前状态（每次更新先改这里）」表：两个阶段的实测结论、下一步（轮子转向确认）、代码规模、构建方式、出厂固件位置；速查表补仓库与备份两行；版本记录补 README/收尾/CI 三条。
2026-09-15 避坑：ESP8266 的 EN(CH_PD) 必须外接 3.3V（实测悬空不启动）
    现象：单独 3.3V 供电时模块完全不启动（蓝灯不亮、串口无输出），插烧录器却正常。根因：EN 悬空——官方 ESP-01S 原理图上 R2 10K 上拉，但我们这块模块不可靠。解决：EN 直接接 3.3V。同时记下：蓝灯接在 TXD/GPIO2 上属数据灯，不能用它判断供电。
    改动：接线表 ESP 表格与一页速查、避坑Checklist A 节新增一条、开发日志踩坑表新增第 13 条、ESP sketch 头部接线注释（仓库与本机草稿本两份）。
2026-09-15 修「跑几秒就停」：ESP 侧不再用「多久没收到摇杆数据」判断松手
    根因：Blinker 摇杆组件只在手指移动时上报，按住不动收不到数据；早先写的 1 秒无数据回中把「按住不动」误判成「松手」，主动把速度归零。改为：保持最后一次摇杆值，只在 !Blinker.connected()（真断线）时归零；停车 = 把摇杆拖回中间。CH32 侧 300ms 链路超时继续兜底。
    现象数据：LINK-OK / 48 帧每秒 / err=5，但 x=y=0 —— 说明串口链路健康，问题在数据源判断。
    [ESP8266_Blinker_Joy.ino]
2026-09-15 开发日志：记录「跑几秒就停」的修复与实测验证
    实测数据：改完后按住推杆 8 秒，y 稳定 +100 不归零，脉宽保持 1999/1943us，frames 932→1268 (48/s) 且 LINK-OK 全程稳定。版本记录补：轮子转向验证通过 + EN 必须接 3.3V + 修正「1 秒无数据即回中」的误判。
2026-09-15 开发日志：补记「停车」验证（拖回中心 → 1500/1500us 立即停）
    实测时间轴：推住 3.5s（1999/1909us 不掉速）→ 拖回中间 → y 回 0、脉宽回 1500/1500 → 再推又能启动。开关车三段动作全部通过。
2026-09-15 OLED 界面：无网络转圈 / 已连接 / 方向箭头
    字模：App/app_glyphs.h（tools/gen_glyphs.py 生成）——11 个 16x16 汉字（无网络已连接停前后左右）+ 8 个 40x40 方向箭头 + 停止图标；行优先 MSB 在左。给方向文字补了「左右」两个字。
    驱动：Bsp/bsp_oled.c/h（软件 I2C，PB6=SCL/PB7=SDA，SSD1306 128x64，帧缓冲 + 分页刷新 + 行优先贴图）。
    界面：App/app_ui.c/h —— 上电显示「无网络」+ 转圈；收到 ESP 的 net=1 显示「已连接」并停留 3 秒；之后显示 8 方向箭头 + 文字；断网退回转圈。每 100ms 时间片重建（仅内容变化时）并分 4 页刷屏，不阻塞电机任务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
2026-09-15 扫地执行机构：边刷 EN + 吸尘电调（车动即开，车停 2 秒后关）
    引脚：边刷 EN = PE8/PE10（J3 第 43/45 脚，高电平输出 5V）；吸尘电调 = PB0 = TIM3_CH3（J4 第 17 脚，与两个驱动电调同一定时器）。
    逻辑（App/app_cleaner.c）：底盘一动 -> 两路 EN 拉高 + 吸尘给 VAC_ON_PULSE_US(1250us)；车停 SWEEP_HOLD_MS(2000ms) 后关；上电头 3 秒给吸尘 0 油门让它解锁。
    bsp_motor 增加 TIM3_CH3 通道与 Motor_SetVacuumPulse()；[stat] 行增加 clean=/vac= 两个字段，不接硬件也能从串口验证逻辑。
2026-09-19 开发日志：更新到最新进度（补记 OLED 与扫地执行机构）
    当前状态表重写：阶段一遥控 / 阶段二驱动电调（含轮子转向确认）/ 阶段三 OLED 界面（代码+烧录+屏幕识别 oled=1）/ 阶段四扫地执行机构（代码完成、硬件待接）。下一步三项：扫地接线与实测、落地跑、OLED 观感确认。代码规模更新为自研约 2100 行。
2026-09-19 修正吸尘方案：RC 电调 -> 内置驱动涡轮风机（18kHz 占空比 + 缓启动）
    实物是带驱动的 4 线涡轮风机（VCC/GND/PWM/FG，12V 1.44A），PWM 是 ~18kHz 占空比调速，不是 RC 电调的 50Hz/1000-2000us。
    引脚改到 PB8 = TIM4_CH3（J4 第 25 脚）：TIM3 已被两个驱动电调定成 50Hz，18kHz 放不进同一个定时器。新增 Bsp/bsp_fan.c/h（18kHz PWM，0%=停 100%=满速），bsp_motor 撤掉原来的 TIM3_CH3 真空通道。
    缓启动：0% -> FAN_ON_DUTY_PCT(50%) 用 1.5 秒；缓降 0.8 秒；车停 2 秒后关。日志字段 vac= 改为 fan=<占空比>%。
    [app_cleaner.c, app_cleaner.h, app_config.h, bsp_fan.c, bsp_fan.h, bsp_motor.c, bsp_motor.h, main.c]
2026-09-19 修：上电后扫地误启动 2 秒
    解锁瞬间把 s_lastMoveMs 设成当前时刻，导致「停车保持 2 秒」窗口在上电时就生效 -> clean=1、风机缓升到 39%。改为视为『很久以前就停了』(now - SWEEP_HOLD_MS)，上电保持 clean=0 fan=0%。
    实测：修复后连续 12 秒 clean=0 fan=0%；顺便在日志里观察到了缓启动过程（fan 从 0% 升到 39% 再降回 0%），证明占空比斜坡逻辑工作正常。
    [app_cleaner.c]
2026-09-19 加雷达嗅探：USART2(PA2/PA3) 收雷达字节，每 0.5s 打一行摘要
    用于验证激光雷达：bsp_uart 增加 USART2 中断接收 + 512B 环形缓冲与 RADAR_* 接口；App/app_radar.c 解析包头(0x55AA/0xA55A)并解出 CT/LSN/起始角/结束角，每 500ms 在 COM4 打印 [rad] 摘要（字节率、包头率、角度、累计与溢出）。接线：雷达 TXD -> PA3 = J3 第 34 脚，GND 共地，VCC 5V，M_CTR 接 3.3V。
    同时验证了 FTDI 适配器回环测试通过（发送 24 字节原样读回），确认 0 字节问题出在雷达侧接线/引脚。
    [app_config.h, app_radar.c, app_radar.h, bsp_uart.c, bsp_uart.h, main.c]
2026-09-19 雷达嗅探实测通过：9400 B/s、168 包/秒、25 点/包（约 4200 点/秒）
    实测数据：[rad] rx=9424 B/s hdr=168/s CT=0x00 pts=25 start=30.97 end=59.49 total=80403 ovf=0。速率与卖家标称 4000 点/秒吻合，说明雷达、波特率(115200)、接线(雷达 TXD -> PA3)全部正确。
    顺手两个修正：雷达摘要行改成纯 ASCII（之前中文在串口读取端显示为 ?）；雷达 RX 环形缓冲 512 -> 1024 字节，消除溢出（原来 8 秒丢 194 字节，现在 ovf=0）。
    待核对：起始/结束角的绝对值会超过 360 度，暂不确定是这个克隆版的角度编码细节还是我按原厂 X2 的字段偏移解析所致；接树莓派跑官方 Y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
    [app_radar.c, bsp_uart.c]
2026-09-19 开发日志：记入扫地实测通过 + 激光雷达验证通过
    当前状态表新增阶段五（雷达数据链路已验证）并把阶段四标为实测通过；版本记录补 09-19 两条（扫地/风机缓启动、雷达 9424 B/s 与 FTDI 回环排查）。
2026-09-19 feat: add YDLIDAR X2 front obstacle avoidance
    [app_avoid.c, app_avoid.h, app_config.h, app_radar.c, app_radar.h, main.c]
2026-09-19 docs: confirm Raspberry Pi AAT-1 UART is 3.3V
2026-09-19 docs: map AAT-1 UART to Pi GPIO14/15
2026-09-19 docs: log Raspberry Pi bring-up progress
2026-09-21 docs: Raspberry Pi WiFi-only networking + SSH key auth; note Clash TUN LAN IPv4 hijack
2026-09-21 docs: Raspberry Pi <-> CH32 UART link verified over AAT-1
2026-09-21 feat(pi): web control console (virtual joystick + MJPEG camera), systemd autostart
2026-09-22 feat: stream sampled lidar points to Pi web console
